KyriePakpahan/chipathon26-SAR_ADC/docs/images/adc_fft.png

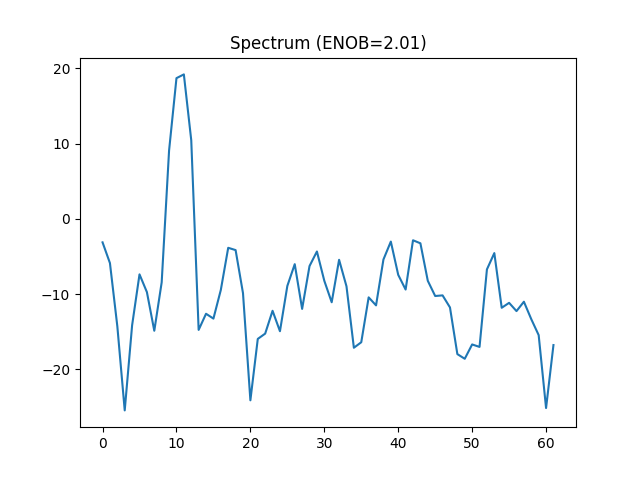
docs/images/adc_fft.png
