KyriePakpahan/chipathon26-SAR_ADC/docs/images/adc_output.png

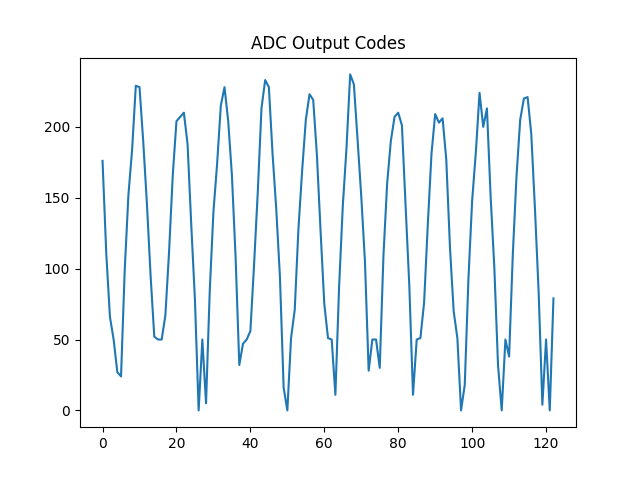
docs/images/adc_output.png
