KyriePakpahan/chipathon26-SAR_ADC/docs/images/async_sar_schematic.png

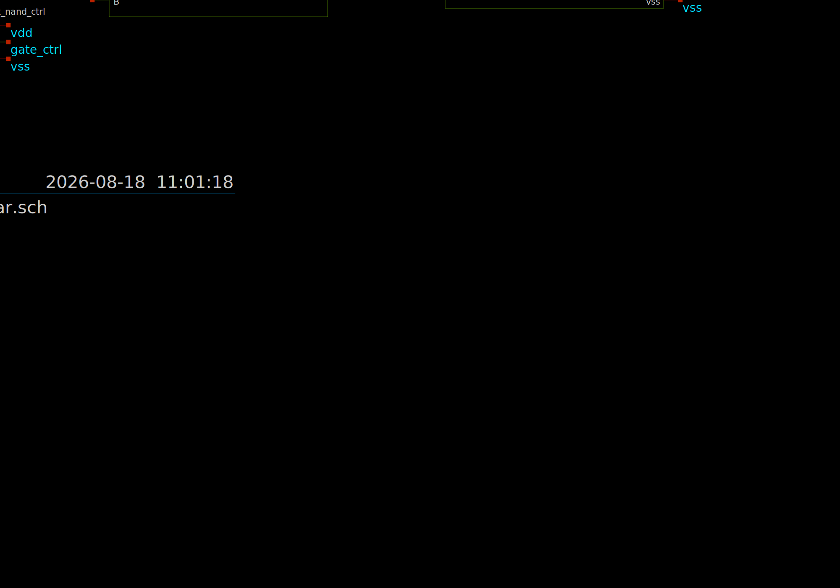
docs/images/async_sar_schematic.png
