KyriePakpahan/chipathon26-SAR_ADC/docs/images/code_vs_vin.png

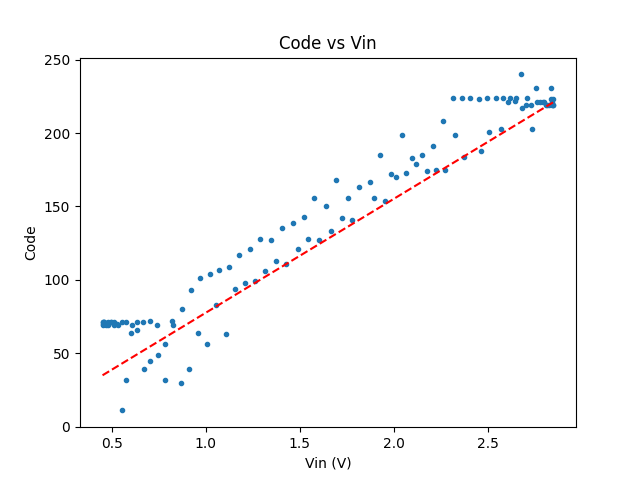
docs/images/code_vs_vin.png
