KyriePakpahan/chipathon26-SAR_ADC/docs/images/dynamic_fft_spectra_annotated.png

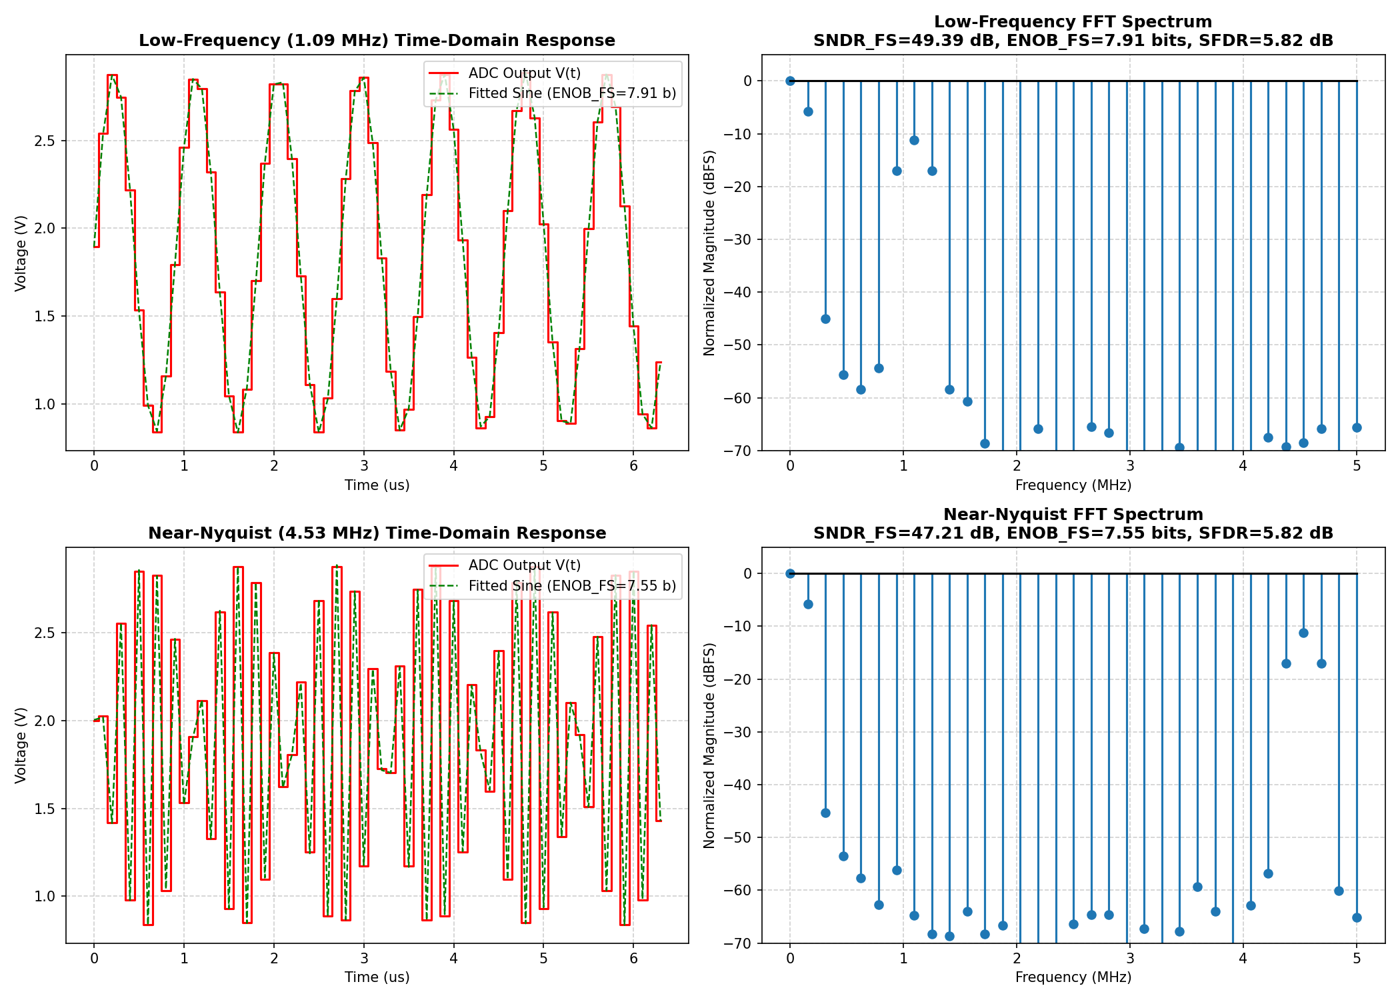
docs/images/dynamic_fft_spectra_annotated.png
