KyriePakpahan/chipathon26-SAR_ADC/docs/images/error_vs_time.png

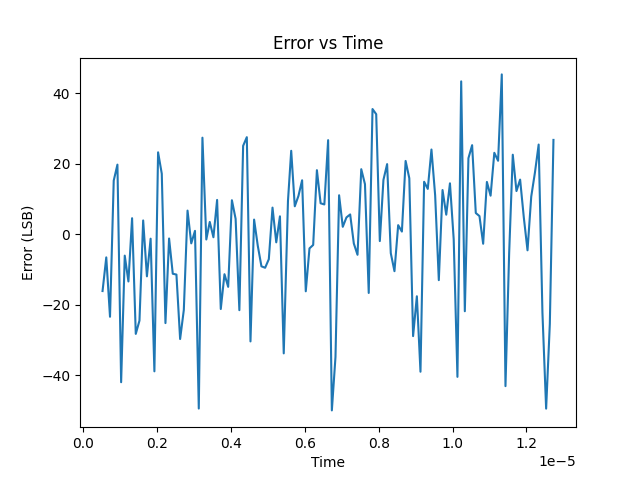
docs/images/error_vs_time.png
