KyriePakpahan/chipathon26-SAR_ADC/docs/images/error_vs_vin.png

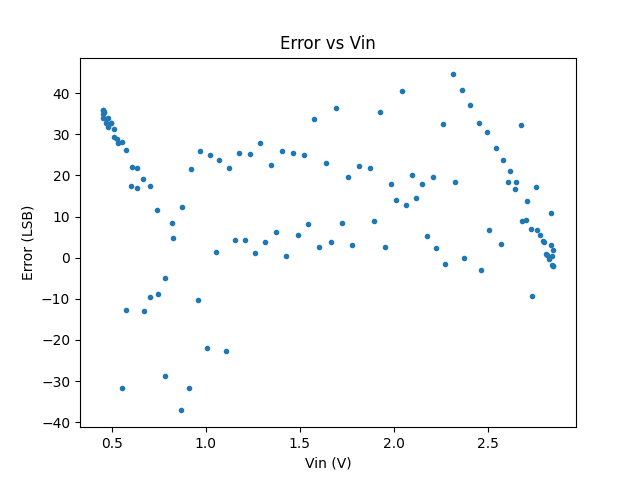
docs/images/error_vs_vin.png
