KyriePakpahan/chipathon26-SAR_ADC/docs/images/fft_out.png

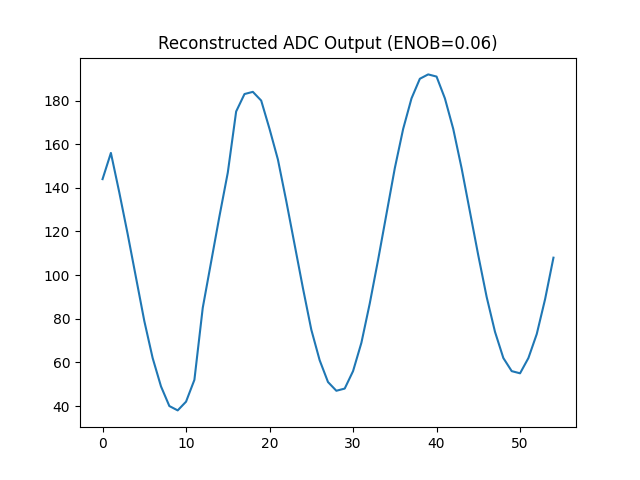
docs/images/fft_out.png
