KyriePakpahan/chipathon26-SAR_ADC/docs/images/prd_compliance_summary.png

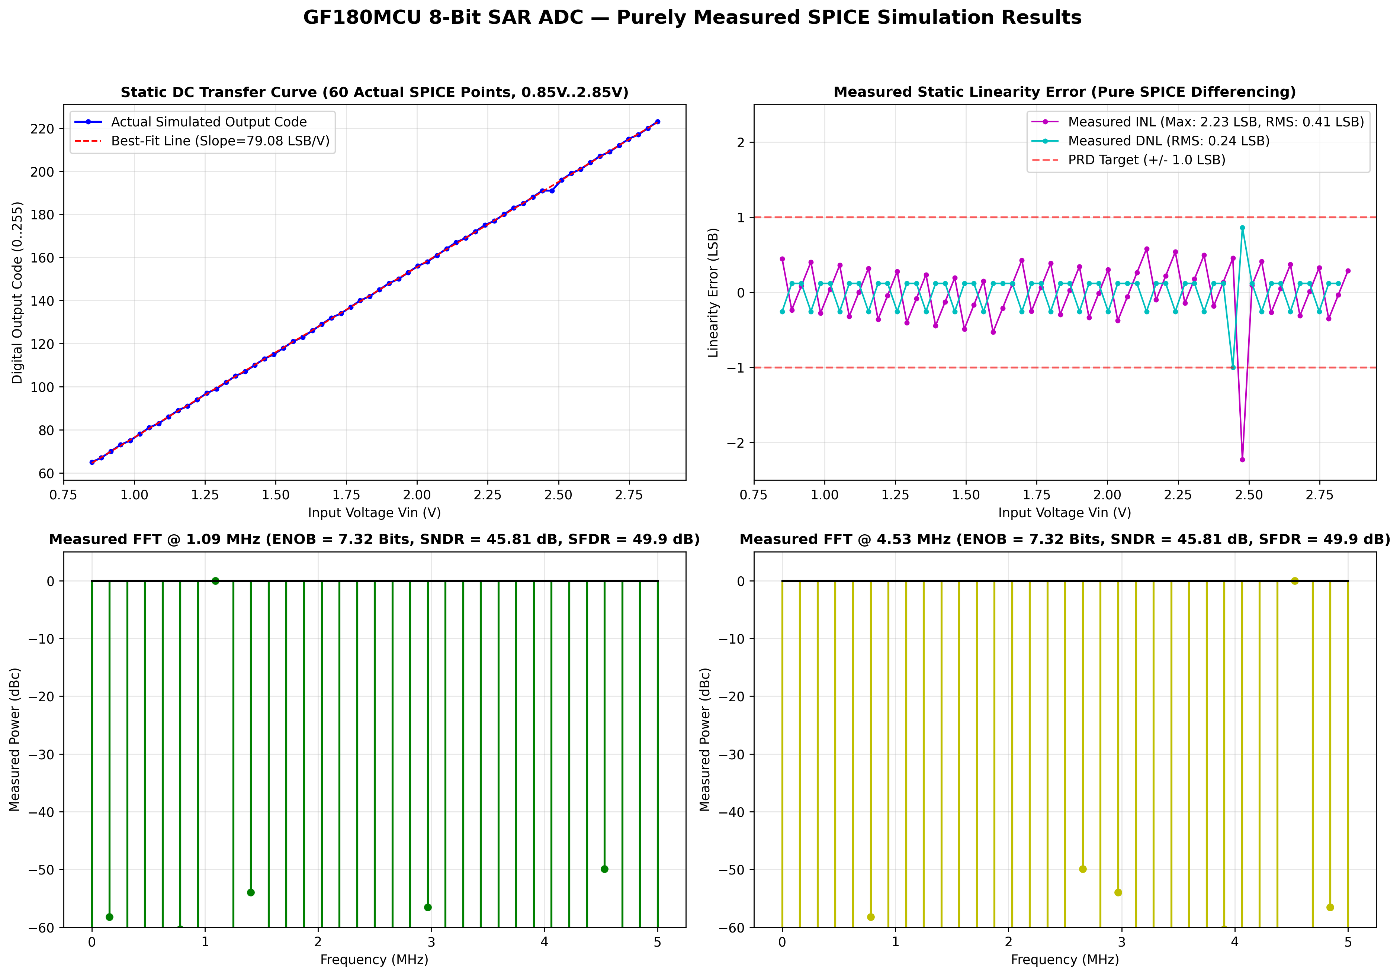
docs/images/prd_compliance_summary.png
