KyriePakpahan/chipathon26-SAR_ADC/docs/images/tb_sar_adc_top_waveform.png

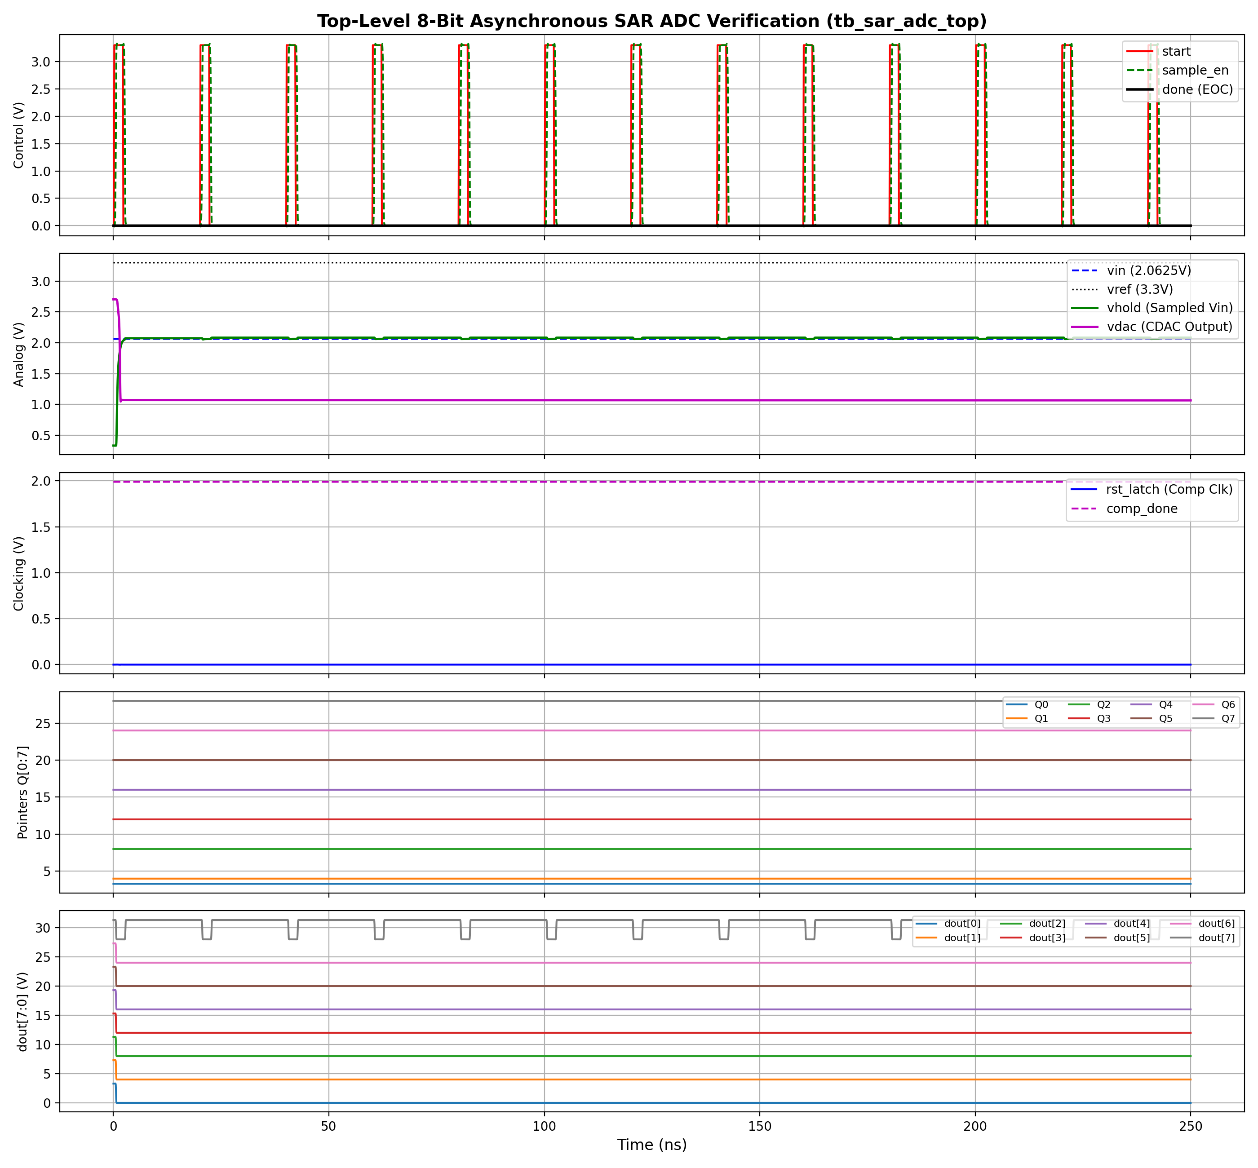
docs/images/tb_sar_adc_top_waveform.png
