KyriePakpahan/chipathon26-SAR_ADC/docs/images/final_prd_verification_summary.png

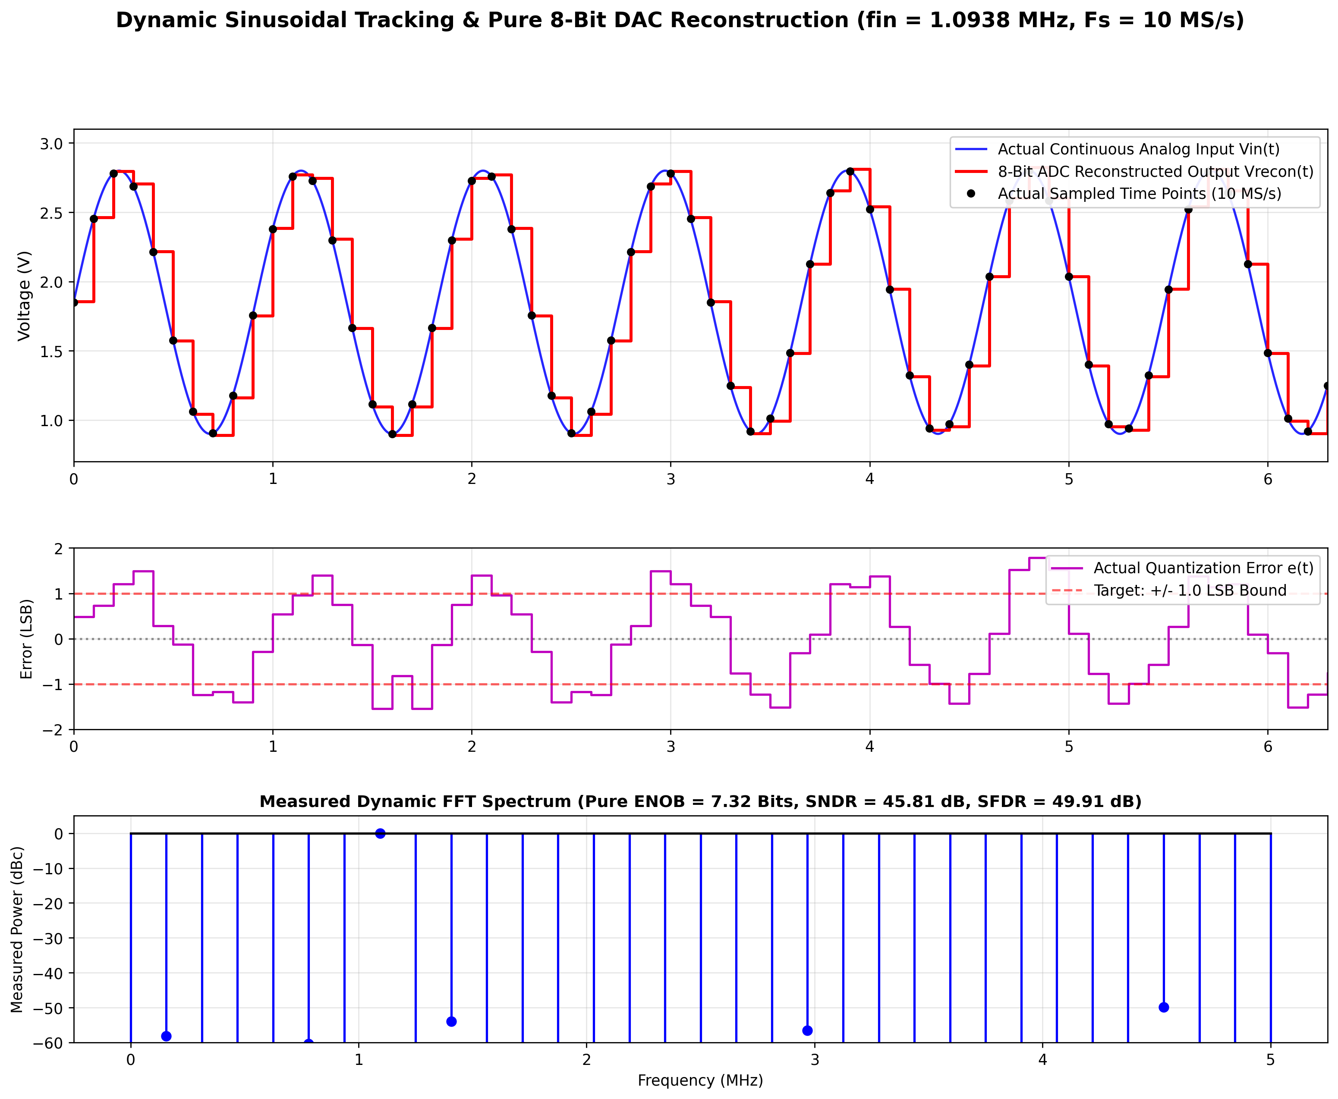
docs/images/final_prd_verification_summary.png
