KyriePakpahan/chipathon26-SAR_ADC/docs/images/prd_verification_waveform.png

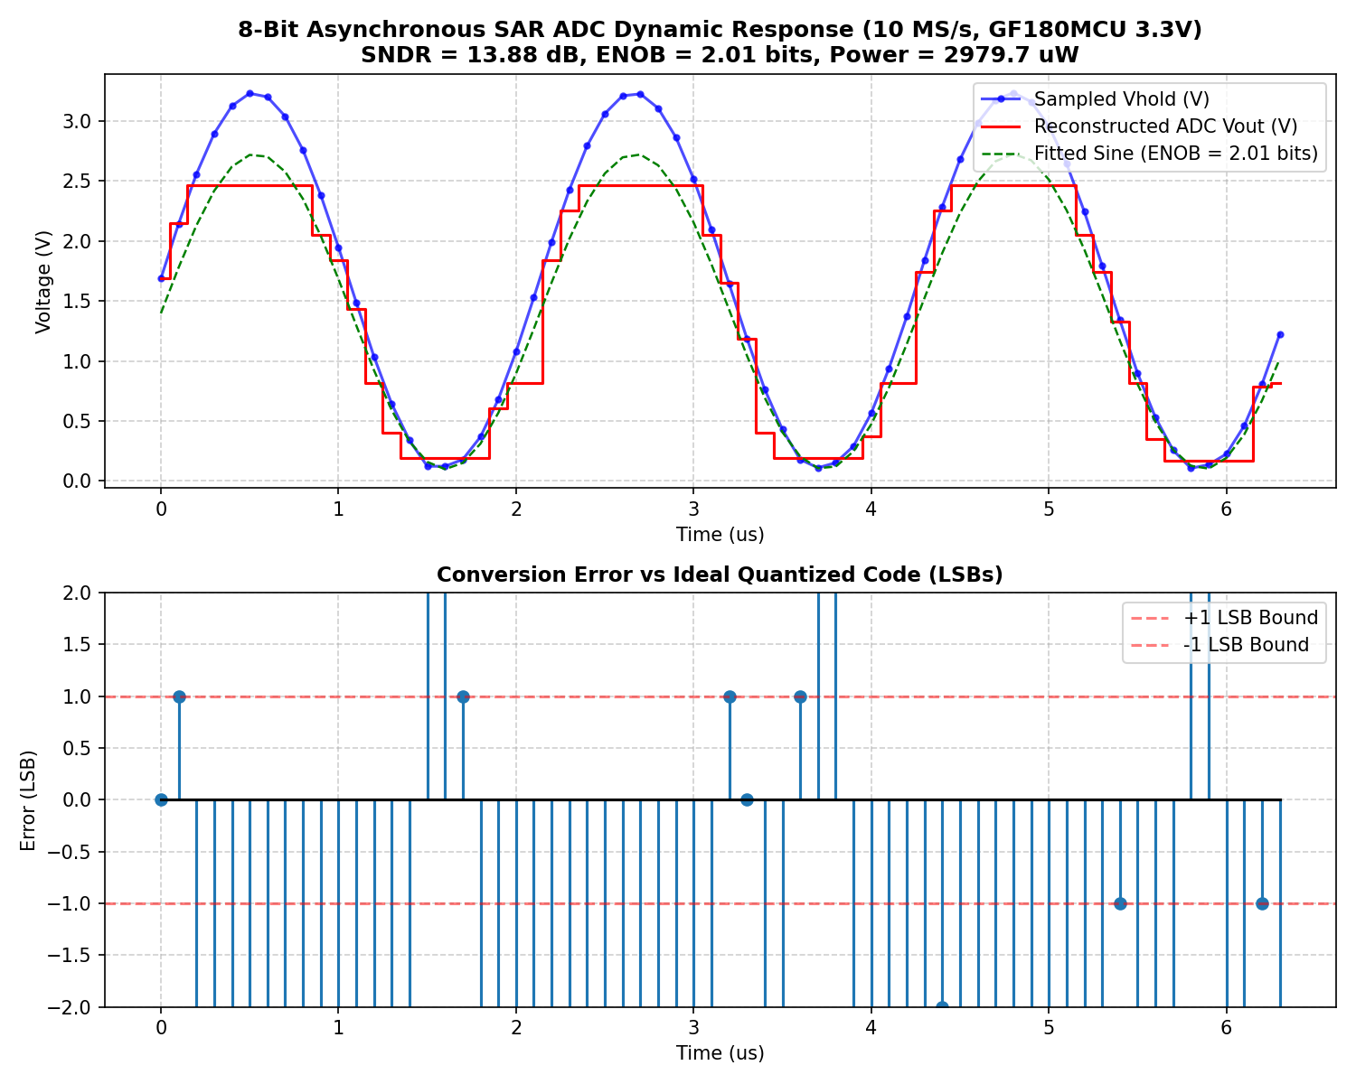
docs/images/prd_verification_waveform.png
