KyriePakpahan/chipathon26-SAR_ADC/docs/images/sinusoidal_dynamic_verification.png

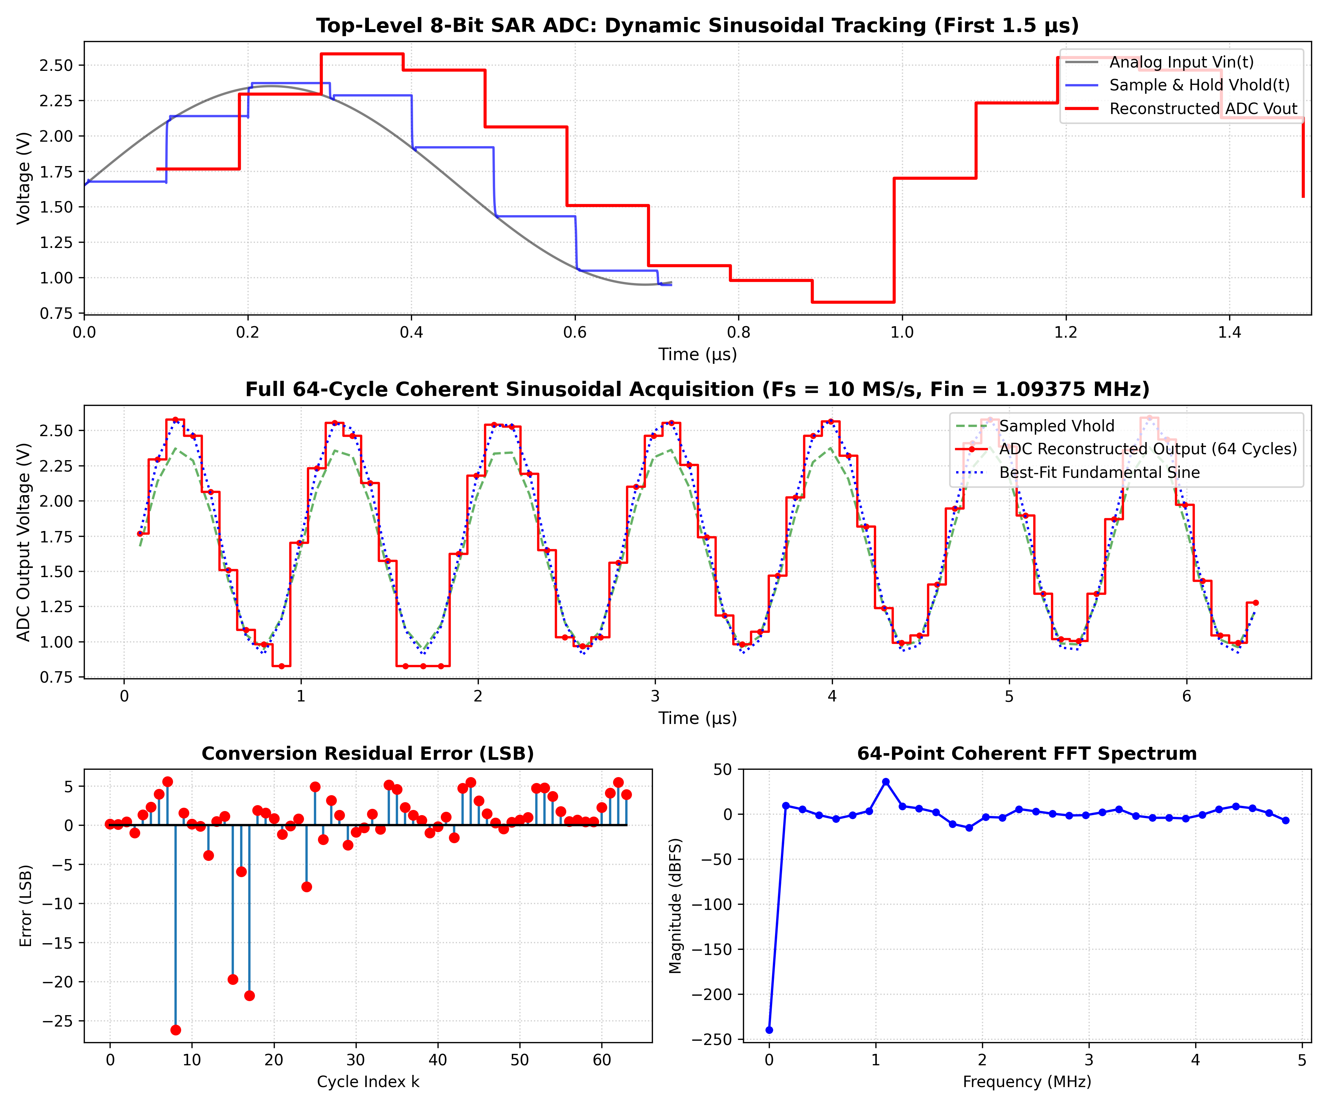
docs/images/sinusoidal_dynamic_verification.png
