KyriePakpahan/chipathon26-SAR_ADC/docs/images/static_inl_dnl_characterization.png

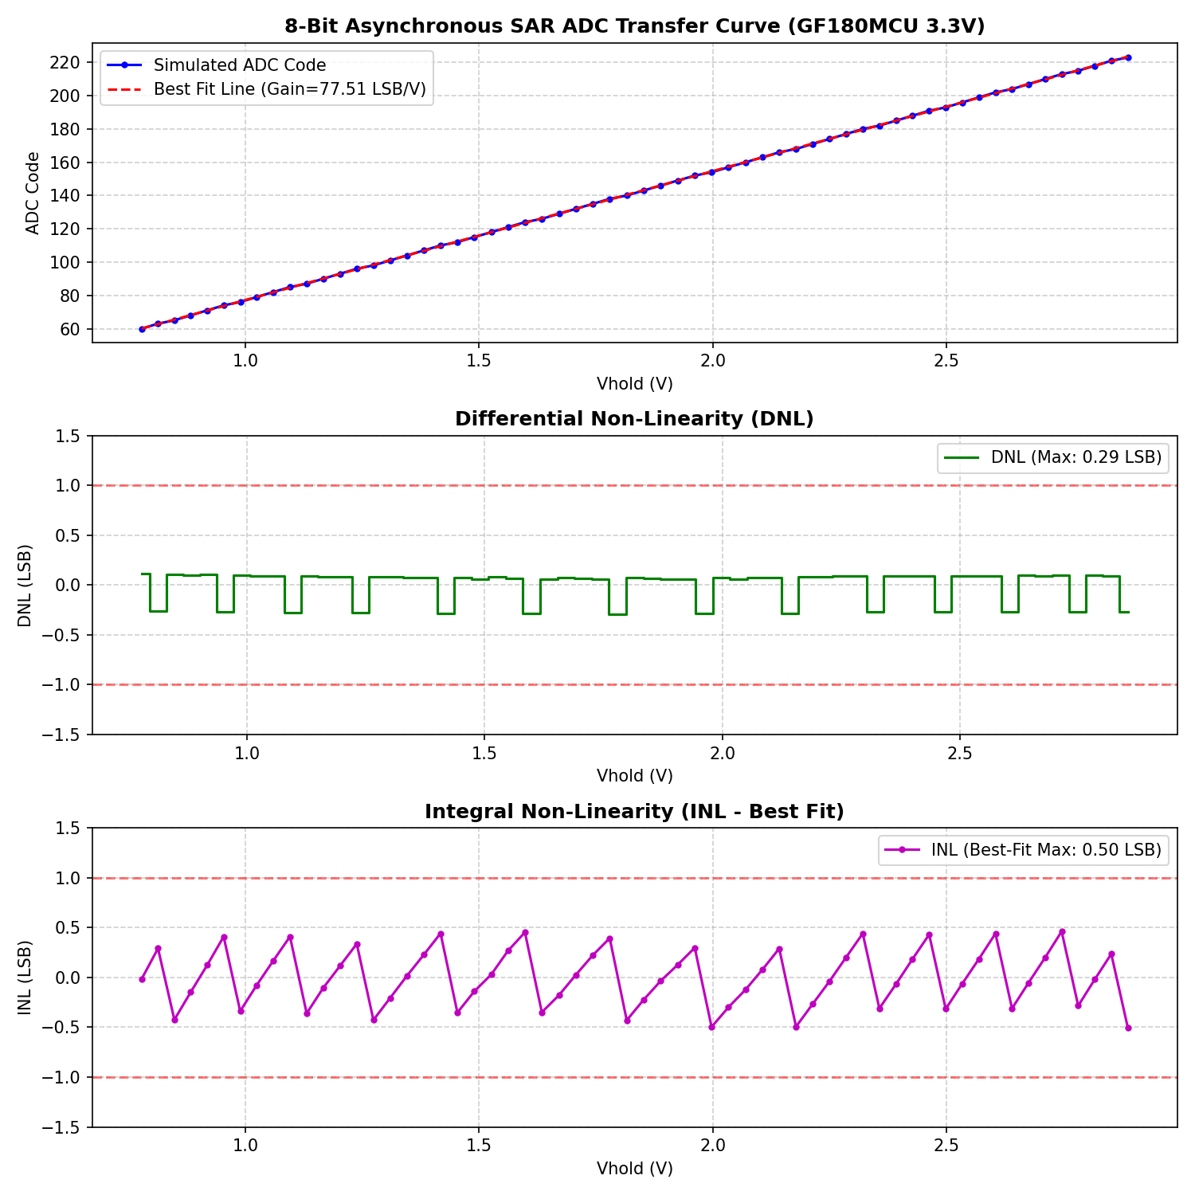
docs/images/static_inl_dnl_characterization.png
