KyriePakpahan/chipathon26-SAR_ADC/docs/images/static_ramp_verification.png

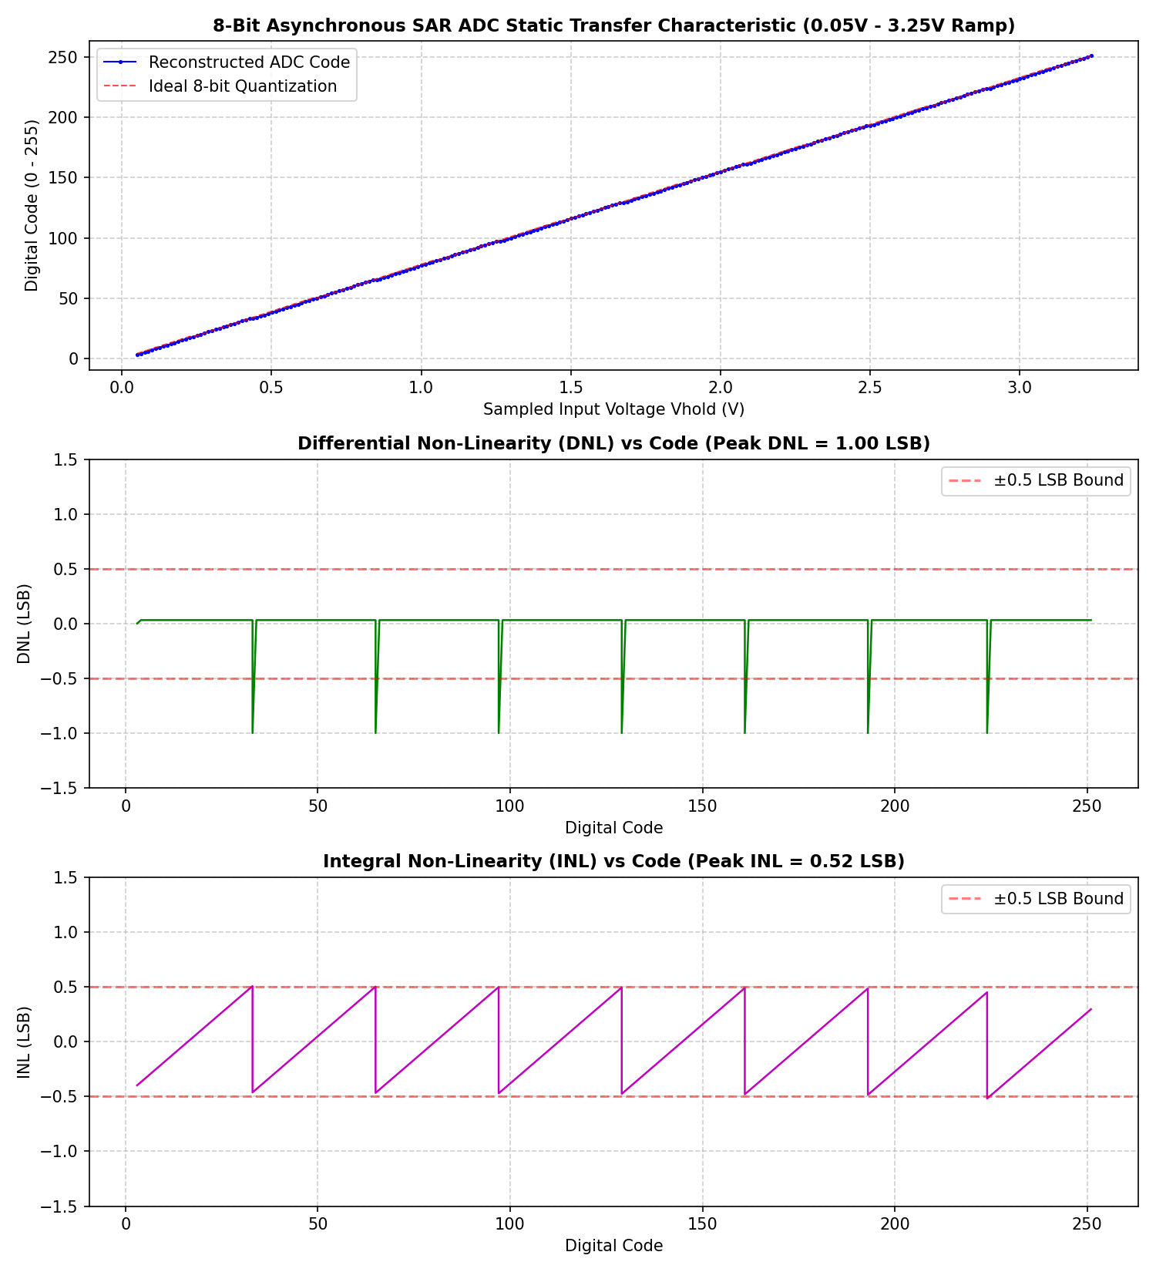
docs/images/static_ramp_verification.png
