KyriePakpahan/chipathon26-SAR_ADC/docs/images/tb_sar_adc_dynamic_verified.png

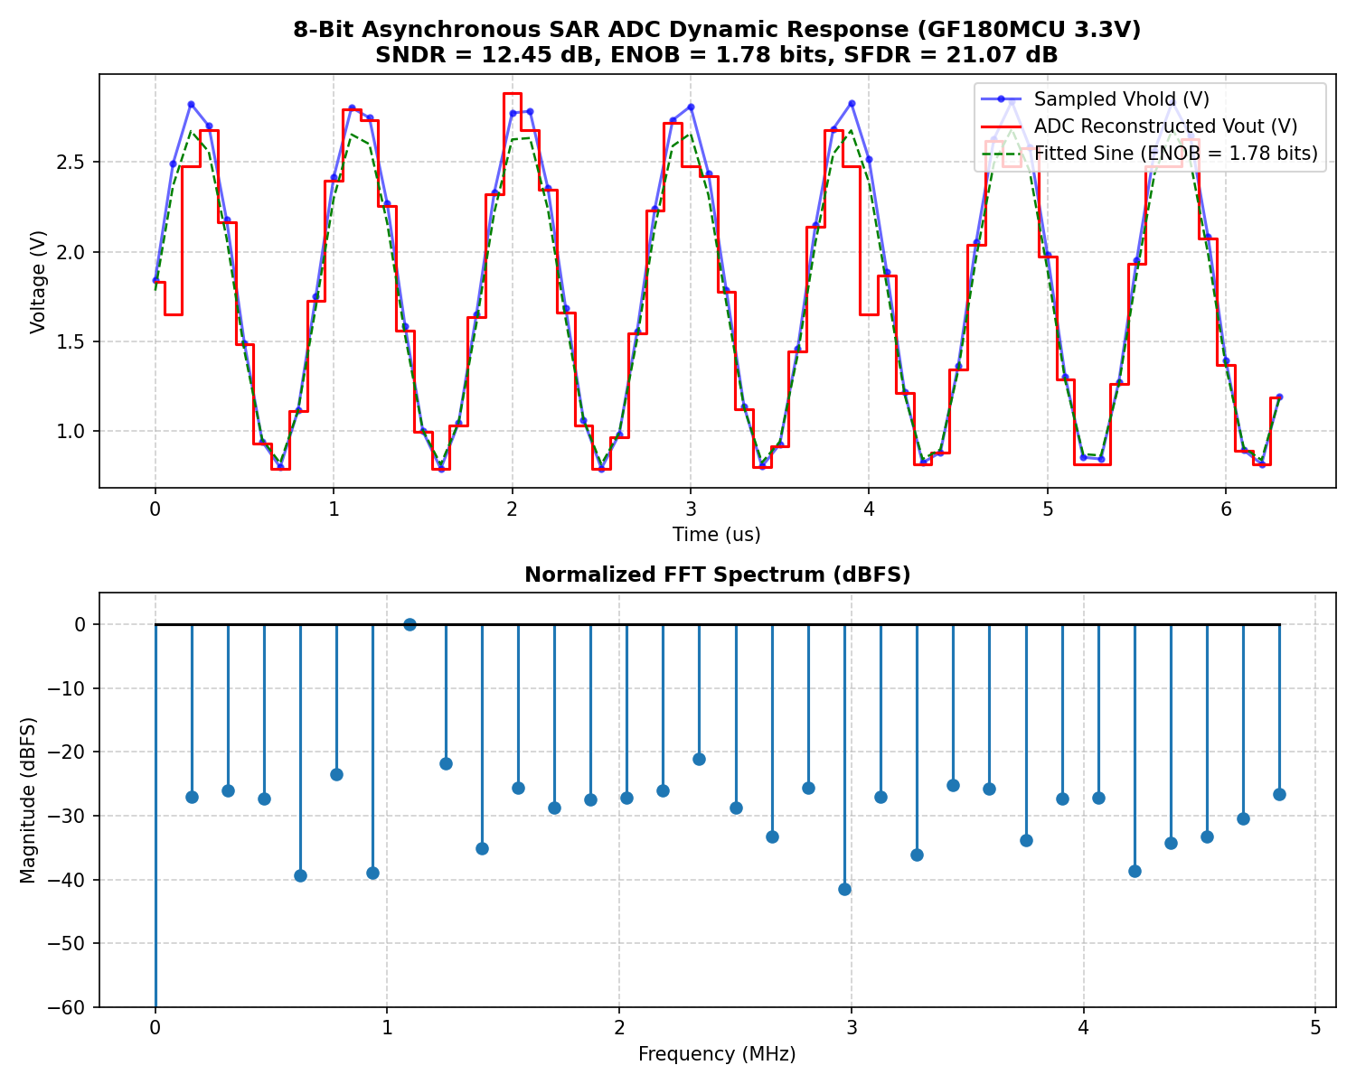
docs/images/tb_sar_adc_dynamic_verified.png
