KyriePakpahan/chipathon26-SAR_ADC/docs/images/tb_sar_adc_top_verified.png

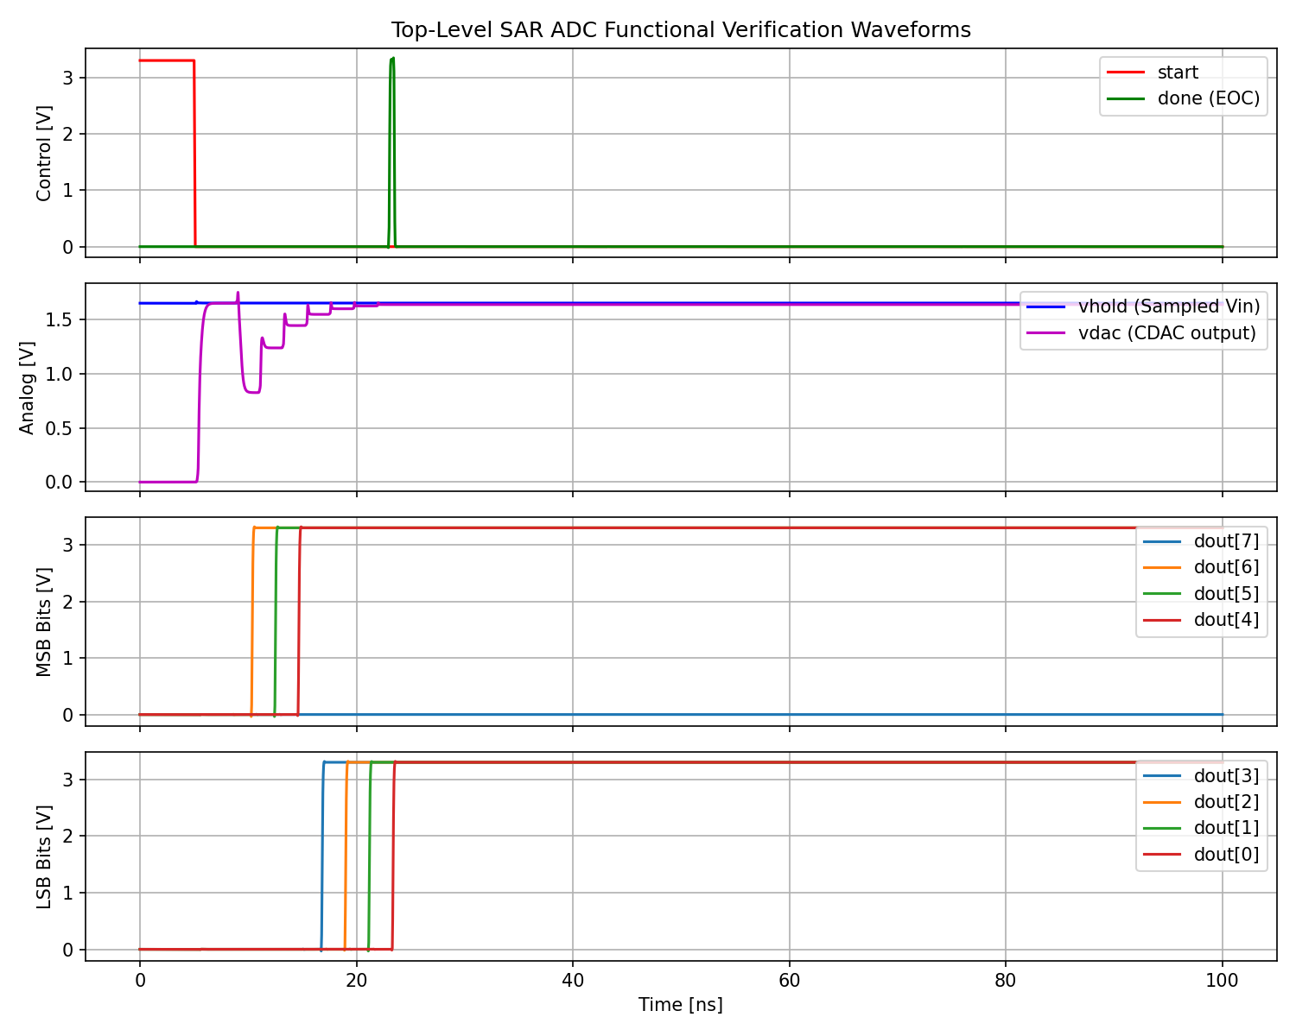
docs/images/tb_sar_adc_top_verified.png
