KyriePakpahan/chipathon26-SAR_ADC/reports/sar_adc_top_performance_panel.png

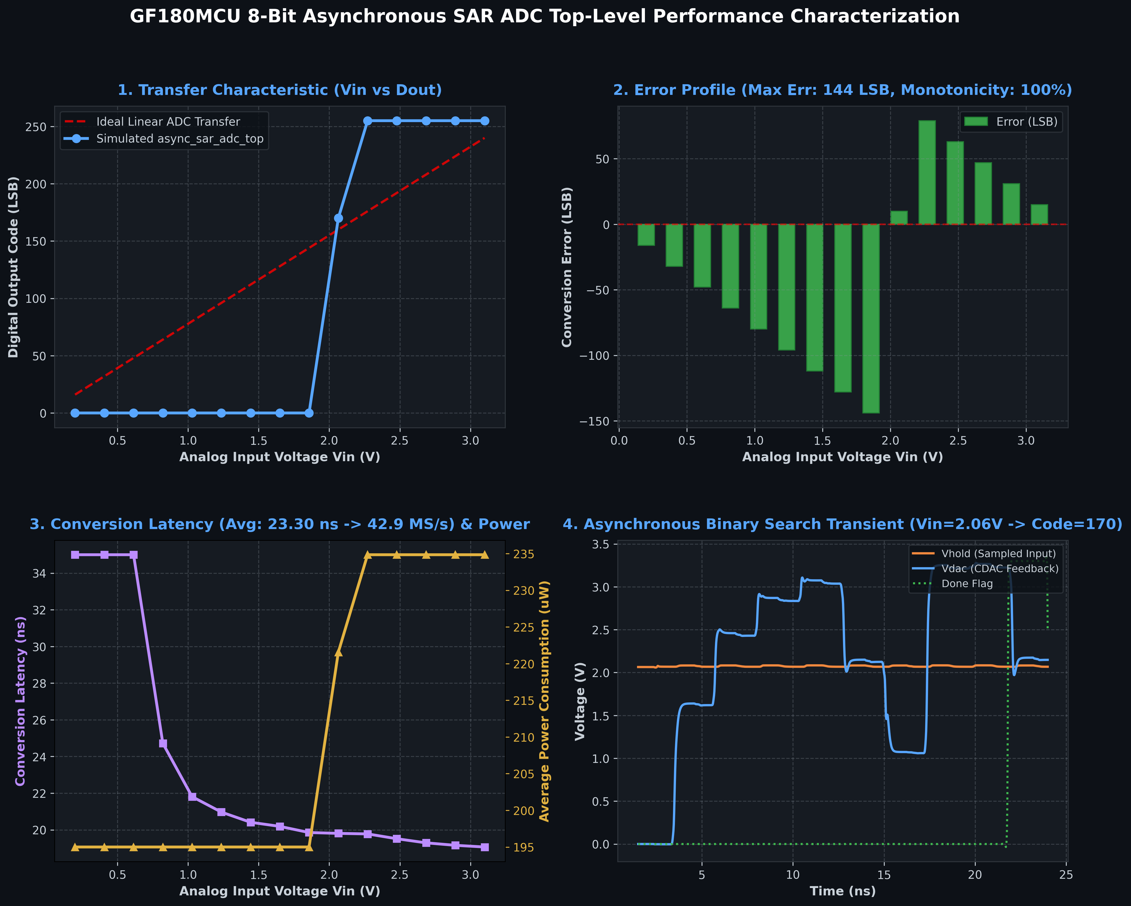
reports/sar_adc_top_performance_panel.png
