KyriePakpahan/chipathon26-SAR_ADC/xschem/sar_adc/blocks/sample_hold/testbench/tb_sample_hold.spice

** sch_path: /foss/designs/chipathon26-SAR_ADC/xschem/sar_adc/blocks/sample_hold/testbench/tb_sample_hold.sch
**.subckt tb_sample_hold
V_VDD vdd 0 3.3
V_VIN vin 0 SINE(1.65 1.5 1Meg)
V_SE sample_en 0 PULSE(0 3.3 0 1n 1n 50n 100n)
x1 vin sample_en vhold vdd 0 sample_hold
**** begin user architecture code


.param fnoicor=0
.param sw_stat_mismatch=0
.include /foss/pdks/gf180mcuD/libs.tech/ngspice/design.ngspice
.lib /foss/pdks/gf180mcuD/libs.tech/ngspice/sm141064.ngspice typical
.lib /foss/pdks/gf180mcuD/libs.tech/ngspice/sm141064.ngspice mimcap_typical
.lib /foss/pdks/gf180mcuD/libs.tech/ngspice/sm141064.ngspice cap_mim
.control
save v(vin) v(sample_en) v(vhold)
tran 0.1n 500n
set filetype=ascii
write tb_sample_hold.raw
quit
.endc

**** end user architecture code
**.ends

* expanding   symbol:  sar_adc/blocks/sample_hold/sample_hold.sym # of pins=5
** sym_path: /foss/designs/chipathon26-SAR_ADC/xschem/sar_adc/blocks/sample_hold/sample_hold.sym
** sch_path: /foss/designs/chipathon26-SAR_ADC/xschem/sar_adc/blocks/sample_hold/sample_hold.sch
.subckt sample_hold vin sample_en vhold vdd vss
*.ipin vin
*.ipin sample_en
*.opin vhold
*.iopin vdd
*.iopin vss
x_inv vdd clkb sample_en vss inv_sh
XC1 net1 vg cap_mim_2f0fF c_width=10e-6 c_length=25e-6
XM4 vin sample_en net1 vss nfet_03v3 L=0.28u W=2.00u nf=1 ad='int((nf+1)/2) * W/nf * 0.18u' as='int((nf+2)/2) * W/nf * 0.18u' pd='2*int((nf+1)/2) * (W/nf + 0.18u)'
+ ps='2*int((nf+2)/2) * (W/nf + 0.18u)' nrd='0.18u / W' nrs='0.18u / W' sa=0 sb=0 sd=0
XM3 vss clkb net1 vss nfet_03v3 L=0.28u W=2.00u nf=1 ad='int((nf+1)/2) * W/nf * 0.18u' as='int((nf+2)/2) * W/nf * 0.18u' pd='2*int((nf+1)/2) * (W/nf + 0.18u)'
+ ps='2*int((nf+2)/2) * (W/nf + 0.18u)' nrd='0.18u / W' nrs='0.18u / W' sa=0 sb=0 sd=0
XM5 vg vg vdd vdd pfet_03v3 L=0.28u W=2.00u nf=1 ad='int((nf+1)/2) * W/nf * 0.18u' as='int((nf+2)/2) * W/nf * 0.18u' pd='2*int((nf+1)/2) * (W/nf + 0.18u)'
+ ps='2*int((nf+2)/2) * (W/nf + 0.18u)' nrd='0.18u / W' nrs='0.18u / W' sa=0 sb=0 sd=0
XM6 vg clkb vg vdd pfet_03v3 L=0.28u W=2.00u nf=1 ad='int((nf+1)/2) * W/nf * 0.18u' as='int((nf+2)/2) * W/nf * 0.18u' pd='2*int((nf+1)/2) * (W/nf + 0.18u)'
+ ps='2*int((nf+2)/2) * (W/nf + 0.18u)' nrd='0.18u / W' nrs='0.18u / W' sa=0 sb=0 sd=0
XM7 net2 vdd vg vss nfet_03v3 L=0.28u W=2.00u nf=1 ad='int((nf+1)/2) * W/nf * 0.18u' as='int((nf+2)/2) * W/nf * 0.18u' pd='2*int((nf+1)/2) * (W/nf + 0.18u)'
+ ps='2*int((nf+2)/2) * (W/nf + 0.18u)' nrd='0.18u / W' nrs='0.18u / W' sa=0 sb=0 sd=0
XM8 vss clkb net2 vss nfet_03v3 L=0.28u W=2.00u nf=1 ad='int((nf+1)/2) * W/nf * 0.18u' as='int((nf+2)/2) * W/nf * 0.18u' pd='2*int((nf+1)/2) * (W/nf + 0.18u)'
+ ps='2*int((nf+2)/2) * (W/nf + 0.18u)' nrd='0.18u / W' nrs='0.18u / W' sa=0 sb=0 sd=0
XM1 vhold vg vin vss nfet_03v3 L=0.28u W=5.00u nf=1 ad='int((nf+1)/2) * W/nf * 0.18u' as='int((nf+2)/2) * W/nf * 0.18u' pd='2*int((nf+1)/2) * (W/nf + 0.18u)'
+ ps='2*int((nf+2)/2) * (W/nf + 0.18u)' nrd='0.18u / W' nrs='0.18u / W' sa=0 sb=0 sd=0
XM2 vin clkb vhold vdd pfet_03v3 L=0.28u W=5.00u nf=1 ad='int((nf+1)/2) * W/nf * 0.18u' as='int((nf+2)/2) * W/nf * 0.18u' pd='2*int((nf+1)/2) * (W/nf + 0.18u)'
+ ps='2*int((nf+2)/2) * (W/nf + 0.18u)' nrd='0.18u / W' nrs='0.18u / W' sa=0 sb=0 sd=0
XC2 vhold vss cap_mim_2f0fF c_width=20e-6 c_length=10e-6
.ends


* expanding   symbol:  sar_adc/blocks/sample_hold/inv_sh.sym # of pins=4
** sym_path: /foss/designs/chipathon26-SAR_ADC/xschem/sar_adc/blocks/sample_hold/inv_sh.sym
** sch_path: /foss/designs/chipathon26-SAR_ADC/xschem/sar_adc/blocks/sample_hold/inv_sh.sch
.subckt inv_sh vdd vo vi vss
*.iopin vdd
*.ipin vi
*.opin vo
*.iopin vss
XM1 vo vi vss vss nfet_03v3 L=0.28u W=1u nf=1 ad='int((nf+1)/2) * W/nf * 0.18u' as='int((nf+2)/2) * W/nf * 0.18u' pd='2*int((nf+1)/2) * (W/nf + 0.18u)'
+ ps='2*int((nf+2)/2) * (W/nf + 0.18u)' nrd='0.18u / W' nrs='0.18u / W' sa=0 sb=0 sd=0
XM2 vo vi vdd vdd pfet_03v3 L=0.28u W=2u nf=1 ad='int((nf+1)/2) * W/nf * 0.18u' as='int((nf+2)/2) * W/nf * 0.18u' pd='2*int((nf+1)/2) * (W/nf + 0.18u)'
+ ps='2*int((nf+2)/2) * (W/nf + 0.18u)' nrd='0.18u / W' nrs='0.18u / W' sa=0 sb=0 sd=0
.ends

.end
