KyriePakpahan/chipathon26-SAR_ADC/netlist/sar_adc_top.spice

** sch_path: /foss/designs/chipathon26-SAR_ADC/xschem/sar_adc/sar_adc_top.sch
.subckt sar_adc_top vin vref start vdd vss done dout[7] dout[6] dout[5] dout[4] dout[3] dout[2] dout[1] dout[0]
*.ipin vin
*.ipin vref
*.ipin start
*.iopin vdd
*.iopin vss
*.opin done
*.opin dout[7]
*.opin dout[6]
*.opin dout[5]
*.opin dout[4]
*.opin dout[3]
*.opin dout[2]
*.opin dout[1]
*.opin dout[0]
x_sh vin sample_en vhold vdd vss sample_hold
x_cdac vref dac_in[7] dac_in[6] dac_in[5] dac_in[4] dac_in[3] dac_in[2] dac_in[1] dac_in[0] vdac vdd vss cdac_8bit
x_comp vhold vdac rst_latch vdd vss comp_out_p comp_out_n comp_done strongarm_comp
x_sar start comp_out_p comp_done vdd vss sample_en rst_latch done dout[7] dout[6] dout[5] dout[4] dout[3] dout[2] dout[1] dout[0]
+ dac_in[7] dac_in[6] dac_in[5] dac_in[4] dac_in[3] dac_in[2] dac_in[1] dac_in[0] async_sar
x_dac_rst vdac sample_en vss dac_rst
x_dec_vref vref vss dec_vref
.ends

* expanding   symbol:  sar_adc/blocks/sample_hold/sample_hold.sym # of pins=5
** sym_path: /foss/designs/chipathon26-SAR_ADC/xschem/sar_adc/blocks/sample_hold/sample_hold.sym
** sch_path: /foss/designs/chipathon26-SAR_ADC/xschem/sar_adc/blocks/sample_hold/sample_hold.sch
.subckt sample_hold vin sample_en vhold vdd vss
*.ipin vin
*.ipin sample_en
*.opin vhold
*.iopin vdd
*.iopin vss
XM1 vhold sample_en vin vss nfet_03v3 L=0.28u W=8.00u nf=4 ad='int((nf+1)/2) * W/nf * 0.18u' as='int((nf+2)/2) * W/nf * 0.18u' pd='2*int((nf+1)/2) * (W/nf + 0.18u)'
+ ps='2*int((nf+2)/2) * (W/nf + 0.18u)' nrd='0.18u / W' nrs='0.18u / W' sa=0 sb=0 sd=0
XM2 vin clkb vhold vdd pfet_03v3 L=0.28u W=16.00u nf=4 ad='int((nf+1)/2) * W/nf * 0.18u' as='int((nf+2)/2) * W/nf * 0.18u' pd='2*int((nf+1)/2) * (W/nf + 0.18u)'
+ ps='2*int((nf+2)/2) * (W/nf + 0.18u)' nrd='0.18u / W' nrs='0.18u / W' sa=0 sb=0 sd=0
XC2 vhold vss cap_mim_2f0fF c_width=15e-6 c_length=10e-6
XM3 clkb sample_en vdd vdd pfet_03v3 L=0.28u W=4.00u nf=2 ad='int((nf+1)/2) * W/nf * 0.18u' as='int((nf+2)/2) * W/nf * 0.18u' pd='2*int((nf+1)/2) * (W/nf + 0.18u)'
+ ps='2*int((nf+2)/2) * (W/nf + 0.18u)' nrd='0.18u / W' nrs='0.18u / W' sa=0 sb=0 sd=0
XM4 clkb sample_en vss vss nfet_03v3 L=0.28u W=2.00u nf=1 ad='int((nf+1)/2) * W/nf * 0.18u' as='int((nf+2)/2) * W/nf * 0.18u' pd='2*int((nf+1)/2) * (W/nf + 0.18u)'
+ ps='2*int((nf+2)/2) * (W/nf + 0.18u)' nrd='0.18u / W' nrs='0.18u / W' sa=0 sb=0 sd=0
.ends


* expanding   symbol:  sar_adc/blocks/cdac/cdac_8bit.sym # of pins=12
** sym_path: /foss/designs/chipathon26-SAR_ADC/xschem/sar_adc/blocks/cdac/cdac_8bit.sym
** sch_path: /foss/designs/chipathon26-SAR_ADC/xschem/sar_adc/blocks/cdac/cdac_8bit.sch
.subckt cdac_8bit vref dac_in[7] dac_in[6] dac_in[5] dac_in[4] dac_in[3] dac_in[2] dac_in[1] dac_in[0] vdac vdd vss
*.ipin vref
*.ipin dac_in[7]
*.ipin dac_in[6]
*.ipin dac_in[5]
*.ipin dac_in[4]
*.ipin dac_in[3]
*.ipin dac_in[2]
*.ipin dac_in[1]
*.ipin dac_in[0]
*.opin vdac
*.iopin vdd
*.iopin vss
X0 dac_in[0] vref vdd vss bot0 cdac_switch_1b
XC0 vdac bot0 cap_mim_2f0fF c_width=5e-6 c_length=5e-6
X1 dac_in[1] vref vdd vss bot1 cdac_switch_1b
XC1 vdac bot1 cap_mim_2f0fF c_width=5e-6 c_length=5e-6 m=2
X2 dac_in[2] vref vdd vss bot2 cdac_switch_1b
XC2 vdac bot2 cap_mim_2f0fF c_width=5e-6 c_length=5e-6 m=4
X3 dac_in[3] vref vdd vss bot3 cdac_switch_1b
XC3 vdac bot3 cap_mim_2f0fF c_width=5e-6 c_length=5e-6 m=8
X4 dac_in[4] vref vdd vss bot4 cdac_switch_1b
XC4 vdac bot4 cap_mim_2f0fF c_width=5e-6 c_length=5e-6 m=16
X5 dac_in[5] vref vdd vss bot5 cdac_switch_1b
XC5 vdac bot5 cap_mim_2f0fF c_width=5e-6 c_length=5e-6 m=32
X6 dac_in[6] vref vdd vss bot6 cdac_switch_1b
XC6 vdac bot6 cap_mim_2f0fF c_width=5e-6 c_length=5e-6 m=64
X7 dac_in[7] vref vdd vss bot7 cdac_switch_1b
XC7 vdac bot7 cap_mim_2f0fF c_width=5e-6 c_length=5e-6 m=128
XC8 vdac vss cap_mim_2f0fF c_width=5e-6 c_length=5e-6
.ends


* expanding   symbol:  sar_adc/blocks/comparator/strongarm_comp.sym # of pins=8
** sym_path: /foss/designs/chipathon26-SAR_ADC/xschem/sar_adc/blocks/comparator/strongarm_comp.sym
** sch_path: /foss/designs/chipathon26-SAR_ADC/xschem/sar_adc/blocks/comparator/strongarm_comp.sch
.subckt strongarm_comp vin_p vin_n rst_latch vdd vss out_p out_n comp_done
*.ipin vin_p
*.ipin vin_n
*.ipin rst_latch
*.iopin vdd
*.iopin vss
*.opin out_p
*.opin out_n
*.opin comp_done
x_core vin_p vin_n rst_latch vdd vss raw_p raw_n strongarm_comp_core
x_inv_p raw_p out_p vdd vss comp_inv_3v3
x_inv_n raw_n out_n vdd vss comp_inv_3v3
x_done_xor out_p out_n comp_done vdd vss comp_xor_fast
.ends


* expanding   symbol:  sar_adc/blocks/async_sar/async_sar.sym # of pins=24
** sym_path: /foss/designs/chipathon26-SAR_ADC/xschem/sar_adc/blocks/async_sar/async_sar.sym
** sch_path: /foss/designs/chipathon26-SAR_ADC/xschem/sar_adc/blocks/async_sar/async_sar.sch
.subckt async_sar start comp_out_p comp_done vdd vss sample_en rst_latch done dout[7] dout[6] dout[5] dout[4] dout[3] dout[2]
+ dout[1] dout[0] dac_in[7] dac_in[6] dac_in[5] dac_in[4] dac_in[3] dac_in[2] dac_in[1] dac_in[0]
*.ipin start
*.ipin comp_out_p
*.ipin comp_done
*.iopin vdd
*.iopin vss
*.opin sample_en
*.opin rst_latch
*.opin done
*.opin dout[7]
*.opin dout[6]
*.opin dout[5]
*.opin dout[4]
*.opin dout[3]
*.opin dout[2]
*.opin dout[1]
*.opin dout[0]
*.opin dac_in[7]
*.opin dac_in[6]
*.opin dac_in[5]
*.opin dac_in[4]
*.opin dac_in[3]
*.opin dac_in[2]
*.opin dac_in[1]
*.opin dac_in[0]
x_inv_srclk vdd comp_done comp_done_b vss async_inverter
x_sr8 vdd vss Q0 Q1 Q2 Q3 Q4 Q5 Q6 Q7 sr_done vss comp_done_b rst_n_int shift_reg_8bit
x_inv_se1 vdd start start_inv vss async_inverter
x_inv_se2 vdd start_inv sample_en vss async_inverter
x_inv_rst_n_int vdd start rst_n_int vss async_inverter
x_bit0 vdd vss dout[0] comp_out_p Q7 rst_n_int bit_reg
x_nor_dq0 dout[0] Q7 dac_n0 vdd vss async_nor2
x_nor_st0 dac_n0 start dac_in[0] vdd vss async_nor2
x_bit1 vdd vss dout[1] comp_out_p Q6 rst_n_int bit_reg
x_nor_dq1 dout[1] Q6 dac_n1 vdd vss async_nor2
x_nor_st1 dac_n1 start dac_in[1] vdd vss async_nor2
x_bit2 vdd vss dout[2] comp_out_p Q5 rst_n_int bit_reg
x_nor_dq2 dout[2] Q5 dac_n2 vdd vss async_nor2
x_nor_st2 dac_n2 start dac_in[2] vdd vss async_nor2
x_bit3 vdd vss dout[3] comp_out_p Q4 rst_n_int bit_reg
x_nor_dq3 dout[3] Q4 dac_n3 vdd vss async_nor2
x_nor_st3 dac_n3 start dac_in[3] vdd vss async_nor2
x_bit4 vdd vss dout[4] comp_out_p Q3 rst_n_int bit_reg
x_nor_dq4 dout[4] Q3 dac_n4 vdd vss async_nor2
x_nor_st4 dac_n4 start dac_in[4] vdd vss async_nor2
x_bit5 vdd vss dout[5] comp_out_p Q2 rst_n_int bit_reg
x_nor_dq5 dout[5] Q2 dac_n5 vdd vss async_nor2
x_nor_st5 dac_n5 start dac_in[5] vdd vss async_nor2
x_bit6 vdd vss dout[6] comp_out_p Q1 rst_n_int bit_reg
x_nor_dq6 dout[6] Q1 dac_n6 vdd vss async_nor2
x_nor_st6 dac_n6 start dac_in[6] vdd vss async_nor2
x_bit7 vdd vss dout[7] comp_out_p Q0 rst_n_int bit_reg
x_nor_dq7 dout[7] Q0 dac_n7 vdd vss async_nor2
x_nor_st7 dac_n7 start dac_in[7] vdd vss async_nor2
x_psettle vdd vss comp_done gate_settle async_pulse_settle
x_start_del vdd vss start start_n async_start_delay
x_inv_dn vdd done done_n vss async_inverter
x_nand_ctrl vdd vss start_n gate_ctrl done_n async_nand2
x_nor_rstl gate_settle gate_ctrl rst_latch vdd vss async_nor2
x_nand_done vdd vss Q7 done_nand comp_done async_nand2
x_inv_done vdd done_nand done vss async_inverter
.ends


* expanding   symbol:  sar_adc/blocks/dac_rst/dac_rst.sym # of pins=3
** sym_path: /foss/designs/chipathon26-SAR_ADC/xschem/sar_adc/blocks/dac_rst/dac_rst.sym
** sch_path: /foss/designs/chipathon26-SAR_ADC/xschem/sar_adc/blocks/dac_rst/dac_rst.sch
.subckt dac_rst vdac sample_en vss
*.iopin vdac
*.ipin sample_en
*.iopin vss
XM1 vdac sample_en vss vss nfet_03v3 L=0.28u W=24.00u nf=6 ad='int((nf+1)/2) * W/nf * 0.18u' as='int((nf+2)/2) * W/nf * 0.18u' pd='2*int((nf+1)/2) * (W/nf + 0.18u)'
+ ps='2*int((nf+2)/2) * (W/nf + 0.18u)' nrd='0.18u / W' nrs='0.18u / W' sa=0 sb=0 sd=0
.ends


* expanding   symbol:  sar_adc/blocks/dec_vref/dec_vref.sym # of pins=2
** sym_path: /foss/designs/chipathon26-SAR_ADC/xschem/sar_adc/blocks/dec_vref/dec_vref.sym
** sch_path: /foss/designs/chipathon26-SAR_ADC/xschem/sar_adc/blocks/dec_vref/dec_vref.sch
.subckt dec_vref vref vss
*.iopin vref
*.iopin vss
XC1 vref vss cap_mim_2f0fF c_width=10e-6 c_length=10e-6 m=20
.ends


* expanding   symbol:  sar_adc/blocks/cdac/cdac_switch_1b.sym # of pins=5
** sym_path: /foss/designs/chipathon26-SAR_ADC/xschem/sar_adc/blocks/cdac/cdac_switch_1b.sym
** sch_path: /foss/designs/chipathon26-SAR_ADC/xschem/sar_adc/blocks/cdac/cdac_switch_1b.sch
.subckt cdac_switch_1b bit vref vdd vss bot
*.ipin bit
*.iopin vref
*.iopin vdd
*.iopin vss
*.iopin bot
XM1 bit_b bit vdd vdd pfet_03v3 L=0.28u W=16.0u nf=4 ad='int((nf+1)/2) * W/nf * 0.18u' as='int((nf+2)/2) * W/nf * 0.18u' pd='2*int((nf+1)/2) * (W/nf + 0.18u)'
+ ps='2*int((nf+2)/2) * (W/nf + 0.18u)' nrd='0.18u / W' nrs='0.18u / W' sa=0 sb=0 sd=0
XM2 bit_b bit vss vss nfet_03v3 L=0.28u W=8.0u nf=2 ad='int((nf+1)/2) * W/nf * 0.18u' as='int((nf+2)/2) * W/nf * 0.18u' pd='2*int((nf+1)/2) * (W/nf + 0.18u)'
+ ps='2*int((nf+2)/2) * (W/nf + 0.18u)' nrd='0.18u / W' nrs='0.18u / W' sa=0 sb=0 sd=0
XM3 bot bit_b vref vdd pfet_03v3 L=0.28u W=32.0u nf=8 ad='int((nf+1)/2) * W/nf * 0.18u' as='int((nf+2)/2) * W/nf * 0.18u' pd='2*int((nf+1)/2) * (W/nf + 0.18u)'
+ ps='2*int((nf+2)/2) * (W/nf + 0.18u)' nrd='0.18u / W' nrs='0.18u / W' sa=0 sb=0 sd=0
XM6 bot bit_b vss vss nfet_03v3 L=0.28u W=24.0u nf=6 ad='int((nf+1)/2) * W/nf * 0.18u' as='int((nf+2)/2) * W/nf * 0.18u' pd='2*int((nf+1)/2) * (W/nf + 0.18u)'
+ ps='2*int((nf+2)/2) * (W/nf + 0.18u)' nrd='0.18u / W' nrs='0.18u / W' sa=0 sb=0 sd=0
.ends


* expanding   symbol:  sar_adc/blocks/comparator/strongarm_comp_core.sym # of pins=7
** sym_path: /foss/designs/chipathon26-SAR_ADC/xschem/sar_adc/blocks/comparator/strongarm_comp_core.sym
** sch_path: /foss/designs/chipathon26-SAR_ADC/xschem/sar_adc/blocks/comparator/strongarm_comp_core.sch
.subckt strongarm_comp_core vin_p vin_n rst_latch vdd vss out_p out_n
*.ipin vin_p
*.ipin vin_n
*.ipin rst_latch
*.iopin vdd
*.iopin vss
*.opin out_p
*.opin out_n
XMtail net_tail rst_latch vss vss nfet_03v3 L=0.28u W=8.00u nf=2 ad='int((nf+1)/2) * W/nf * 0.18u' as='int((nf+2)/2) * W/nf * 0.18u'
+ pd='2*int((nf+1)/2) * (W/nf + 0.18u)' ps='2*int((nf+2)/2) * (W/nf + 0.18u)' nrd='0.18u / W' nrs='0.18u / W' sa=0 sb=0 sd=0
XM1 fn_p vin_p net_tail vss nfet_03v3 L=0.28u W=6.00u nf=2 ad='int((nf+1)/2) * W/nf * 0.18u' as='int((nf+2)/2) * W/nf * 0.18u' pd='2*int((nf+1)/2) * (W/nf + 0.18u)'
+ ps='2*int((nf+2)/2) * (W/nf + 0.18u)' nrd='0.18u / W' nrs='0.18u / W' sa=0 sb=0 sd=0
XM2 fn_n vin_n net_tail vss nfet_03v3 L=0.28u W=6.00u nf=2 ad='int((nf+1)/2) * W/nf * 0.18u' as='int((nf+2)/2) * W/nf * 0.18u' pd='2*int((nf+1)/2) * (W/nf + 0.18u)'
+ ps='2*int((nf+2)/2) * (W/nf + 0.18u)' nrd='0.18u / W' nrs='0.18u / W' sa=0 sb=0 sd=0
XM3 out_p out_n fn_p vss nfet_03v3 L=0.28u W=3.50u nf=1 ad='int((nf+1)/2) * W/nf * 0.18u' as='int((nf+2)/2) * W/nf * 0.18u' pd='2*int((nf+1)/2) * (W/nf + 0.18u)'
+ ps='2*int((nf+2)/2) * (W/nf + 0.18u)' nrd='0.18u / W' nrs='0.18u / W' sa=0 sb=0 sd=0
XM4 out_n out_p fn_n vss nfet_03v3 L=0.28u W=3.50u nf=1 ad='int((nf+1)/2) * W/nf * 0.18u' as='int((nf+2)/2) * W/nf * 0.18u' pd='2*int((nf+1)/2) * (W/nf + 0.18u)'
+ ps='2*int((nf+2)/2) * (W/nf + 0.18u)' nrd='0.18u / W' nrs='0.18u / W' sa=0 sb=0 sd=0
XM5 out_p out_n vdd vdd pfet_03v3 L=0.28u W=4.20u nf=2 ad='int((nf+1)/2) * W/nf * 0.18u' as='int((nf+2)/2) * W/nf * 0.18u' pd='2*int((nf+1)/2) * (W/nf + 0.18u)'
+ ps='2*int((nf+2)/2) * (W/nf + 0.18u)' nrd='0.18u / W' nrs='0.18u / W' sa=0 sb=0 sd=0
XM6 out_n out_p vdd vdd pfet_03v3 L=0.28u W=4.20u nf=2 ad='int((nf+1)/2) * W/nf * 0.18u' as='int((nf+2)/2) * W/nf * 0.18u' pd='2*int((nf+1)/2) * (W/nf + 0.18u)'
+ ps='2*int((nf+2)/2) * (W/nf + 0.18u)' nrd='0.18u / W' nrs='0.18u / W' sa=0 sb=0 sd=0
XM7 out_p rst_latch vdd vdd pfet_03v3 L=0.28u W=2.00u nf=1 ad='int((nf+1)/2) * W/nf * 0.18u' as='int((nf+2)/2) * W/nf * 0.18u' pd='2*int((nf+1)/2) * (W/nf + 0.18u)'
+ ps='2*int((nf+2)/2) * (W/nf + 0.18u)' nrd='0.18u / W' nrs='0.18u / W' sa=0 sb=0 sd=0
XM8 out_n rst_latch vdd vdd pfet_03v3 L=0.28u W=2.00u nf=1 ad='int((nf+1)/2) * W/nf * 0.18u' as='int((nf+2)/2) * W/nf * 0.18u' pd='2*int((nf+1)/2) * (W/nf + 0.18u)'
+ ps='2*int((nf+2)/2) * (W/nf + 0.18u)' nrd='0.18u / W' nrs='0.18u / W' sa=0 sb=0 sd=0
XM9 fn_p rst_latch vdd vdd pfet_03v3 L=0.28u W=2.00u nf=1 ad='int((nf+1)/2) * W/nf * 0.18u' as='int((nf+2)/2) * W/nf * 0.18u' pd='2*int((nf+1)/2) * (W/nf + 0.18u)'
+ ps='2*int((nf+2)/2) * (W/nf + 0.18u)' nrd='0.18u / W' nrs='0.18u / W' sa=0 sb=0 sd=0
XM10 fn_n rst_latch vdd vdd pfet_03v3 L=0.28u W=2.00u nf=1 ad='int((nf+1)/2) * W/nf * 0.18u' as='int((nf+2)/2) * W/nf * 0.18u' pd='2*int((nf+1)/2) * (W/nf + 0.18u)'
+ ps='2*int((nf+2)/2) * (W/nf + 0.18u)' nrd='0.18u / W' nrs='0.18u / W' sa=0 sb=0 sd=0
.ends


* expanding   symbol:  sar_adc/blocks/comparator/comp_inv_3v3.sym # of pins=4
** sym_path: /foss/designs/chipathon26-SAR_ADC/xschem/sar_adc/blocks/comparator/comp_inv_3v3.sym
** sch_path: /foss/designs/chipathon26-SAR_ADC/xschem/sar_adc/blocks/comparator/comp_inv_3v3.sch
.subckt comp_inv_3v3 vi vo vdd vss
*.ipin vi
*.opin vo
*.iopin vdd
*.iopin vss
XM2 vo vi vdd vdd pfet_03v3 L=0.28u W=4.00u nf=1 ad='int((nf+1)/2) * W/nf * 0.18u' as='int((nf+2)/2) * W/nf * 0.18u' pd='2*int((nf+1)/2) * (W/nf + 0.18u)'
+ ps='2*int((nf+2)/2) * (W/nf + 0.18u)' nrd='0.18u / W' nrs='0.18u / W' sa=0 sb=0 sd=0
XM1 vo vi vss vss nfet_03v3 L=0.28u W=1.60u nf=1 ad='int((nf+1)/2) * W/nf * 0.18u' as='int((nf+2)/2) * W/nf * 0.18u' pd='2*int((nf+1)/2) * (W/nf + 0.18u)'
+ ps='2*int((nf+2)/2) * (W/nf + 0.18u)' nrd='0.18u / W' nrs='0.18u / W' sa=0 sb=0 sd=0
.ends


* expanding   symbol:  sar_adc/blocks/comparator/comp_xor_fast.sym # of pins=5
** sym_path: /foss/designs/chipathon26-SAR_ADC/xschem/sar_adc/blocks/comparator/comp_xor_fast.sym
** sch_path: /foss/designs/chipathon26-SAR_ADC/xschem/sar_adc/blocks/comparator/comp_xor_fast.sch
.subckt comp_xor_fast a b y vdd vss
*.ipin a
*.ipin b
*.opin y
*.iopin vdd
*.iopin vss
x1 vdd vss a nab b async_nand2
x2 vdd vss a a_nab nab async_nand2
x3 vdd vss b b_nab nab async_nand2
x4 vdd vss a_nab y b_nab async_nand2
.ends


* expanding   symbol:  sar_adc/blocks/async_sar/async_inverter.sym # of pins=4
** sym_path: /foss/designs/chipathon26-SAR_ADC/xschem/sar_adc/blocks/async_sar/async_inverter.sym
** sch_path: /foss/designs/chipathon26-SAR_ADC/xschem/sar_adc/blocks/async_sar/async_inverter.sch
.subckt async_inverter vdd input out vss
*.ipin input
*.opin out
*.iopin vdd
*.iopin vss
XM5 out input vdd vdd pfet_03v3 L=0.28u W=1.00u nf=1 ad='int((nf+1)/2) * W/nf * 0.18u' as='int((nf+2)/2) * W/nf * 0.18u' pd='2*int((nf+1)/2) * (W/nf + 0.18u)'
+ ps='2*int((nf+2)/2) * (W/nf + 0.18u)' nrd='0.18u / W' nrs='0.18u / W' sa=0 sb=0 sd=0
XM6 out input vss vss nfet_03v3 L=0.28u W=0.50u nf=1 ad='int((nf+1)/2) * W/nf * 0.18u' as='int((nf+2)/2) * W/nf * 0.18u' pd='2*int((nf+1)/2) * (W/nf + 0.18u)'
+ ps='2*int((nf+2)/2) * (W/nf + 0.18u)' nrd='0.18u / W' nrs='0.18u / W' sa=0 sb=0 sd=0
.ends


* expanding   symbol:  sar_adc/blocks/async_sar/shift_reg_8bit.sym # of pins=14
** sym_path: /foss/designs/chipathon26-SAR_ADC/xschem/sar_adc/blocks/async_sar/shift_reg_8bit.sym
** sch_path: /foss/designs/chipathon26-SAR_ADC/xschem/sar_adc/blocks/async_sar/shift_reg_8bit.sch
.subckt shift_reg_8bit vdd vss Q0 Q1 Q2 Q3 Q4 Q5 Q6 Q7 done serial_in clk rst_n
*.ipin serial_in
*.ipin clk
*.ipin rst_n
*.opin Q0
*.opin Q1
*.opin Q2
*.opin Q3
*.opin Q4
*.opin Q5
*.opin Q6
*.opin Q7
*.opin done
*.iopin vdd
*.iopin vss
x1 vdd vss Q0 serial_in clk rst_n dff_cell_set
x2 Q0 clk vdd vss rst_n Q1 dff_cell
x3 Q1 clk vdd vss rst_n Q2 dff_cell
x4 Q2 clk vdd vss rst_n Q3 dff_cell
x5 Q3 clk vdd vss rst_n Q4 dff_cell
x6 Q4 clk vdd vss rst_n Q5 dff_cell
x7 Q5 clk vdd vss rst_n Q6 dff_cell
x8 Q6 clk vdd vss rst_n Q7 dff_cell
x9 Q7 clk vdd vss rst_n done dff_cell
.ends


* expanding   symbol:  sar_adc/blocks/async_sar/bit_reg.sym # of pins=6
** sym_path: /foss/designs/chipathon26-SAR_ADC/xschem/sar_adc/blocks/async_sar/bit_reg.sym
** sch_path: /foss/designs/chipathon26-SAR_ADC/xschem/sar_adc/blocks/async_sar/bit_reg.sch
.subckt bit_reg vdd vss bit_out comp_out en rst_n
*.ipin comp_out
*.ipin en
*.ipin rst_n
*.opin bit_out
*.iopin vdd
*.iopin vss
x_nand_set vdd vss comp_out set_n en async_nand2
x_inv_set vdd set_n set vss async_inverter
x_inv_rst vdd rst_n rst vss async_inverter
x_nor_q rst bit_out_bar bit_out vdd vss async_nor2
x_nor_qb set bit_out bit_out_bar vdd vss async_nor2
.ends


* expanding   symbol:  sar_adc/blocks/async_sar/async_nor2.sym # of pins=5
** sym_path: /foss/designs/chipathon26-SAR_ADC/xschem/sar_adc/blocks/async_sar/async_nor2.sym
** sch_path: /foss/designs/chipathon26-SAR_ADC/xschem/sar_adc/blocks/async_sar/async_nor2.sch
.subckt async_nor2 A B Y vdd vss
*.ipin A
*.ipin B
*.opin Y
*.iopin vdd
*.iopin vss
x1 vdd A A_b vss async_inverter
x2 vdd B B_b vss async_inverter
x3 vdd vss A_b net1 B_b async_nand2
x4 vdd net1 Y vss async_inverter
.ends


* expanding   symbol:  sar_adc/blocks/async_sar/async_pulse_settle.sym # of pins=4
** sym_path: /foss/designs/chipathon26-SAR_ADC/xschem/sar_adc/blocks/async_sar/async_pulse_settle.sym
** sch_path: /foss/designs/chipathon26-SAR_ADC/xschem/sar_adc/blocks/async_sar/async_pulse_settle.sch
.subckt async_pulse_settle vdd vss in out
*.ipin in
*.iopin vdd
*.iopin vss
*.opin out
x_inv vdd in in_inv vss async_inverter
x_del vdd vss in in_del_n async_delay_chain
x_nand vdd vss in_inv out in_del_n async_nand2
.ends


* expanding   symbol:  sar_adc/blocks/async_sar/async_start_delay.sym # of pins=4
** sym_path: /foss/designs/chipathon26-SAR_ADC/xschem/sar_adc/blocks/async_sar/async_start_delay.sym
** sch_path: /foss/designs/chipathon26-SAR_ADC/xschem/sar_adc/blocks/async_sar/async_start_delay.sch
.subckt async_start_delay vdd vss in out
*.ipin in
*.iopin vdd
*.iopin vss
*.opin out
x1 vdd in net1 vss async_inverter
x2 vdd net1 net2 vss async_inverter
x3 vdd net2 net3 vss async_inverter
x4 vdd net3 net4 vss async_inverter
x5 vdd net4 net5 vss async_inverter
x6 vdd net5 net6 vss async_inverter
x7 vdd net6 net7 vss async_inverter
x8 vdd net7 net8 vss async_inverter
x9 vdd net8 net9 vss async_inverter
x10 vdd net9 net10 vss async_inverter
x11 vdd net10 net11 vss async_inverter
x12 vdd net11 net12 vss async_inverter
x13 vdd net12 net13 vss async_inverter
x14 vdd net13 net14 vss async_inverter
x15 vdd net14 net15 vss async_inverter
x16 vdd net15 net16 vss async_inverter
x17 vdd net16 net17 vss async_inverter
x18 vdd net17 net18 vss async_inverter
x19 vdd net18 net19 vss async_inverter
x20 vdd net19 net20 vss async_inverter
x21 vdd net20 net21 vss async_inverter
x22 vdd net21 net22 vss async_inverter
x23 vdd net22 net23 vss async_inverter
x24 vdd net23 net24 vss async_inverter
x25 vdd net24 net25 vss async_inverter
x26 vdd net25 net26 vss async_inverter
x27 vdd net26 net27 vss async_inverter
x28 vdd net27 net28 vss async_inverter
x29 vdd net28 net29 vss async_inverter
x30 vdd net29 net30 vss async_inverter
x31 vdd net30 net31 vss async_inverter
x32 vdd net31 net32 vss async_inverter
x33 vdd net32 net33 vss async_inverter
x34 vdd net33 net34 vss async_inverter
x35 vdd net34 net35 vss async_inverter
x36 vdd net35 net36 vss async_inverter
x37 vdd net36 net37 vss async_inverter
x38 vdd net37 net38 vss async_inverter
x39 vdd net38 net39 vss async_inverter
x40 vdd net39 net40 vss async_inverter
x41 vdd net40 net41 vss async_inverter
x42 vdd net41 net42 vss async_inverter
x43 vdd net42 net43 vss async_inverter
x44 vdd net43 net44 vss async_inverter
x45 vdd net44 out vss async_inverter
XC_start_tune out vss cap_mim_2f0fF c_width=8.66e-6 c_length=8.66e-6
.ends


* expanding   symbol:  sar_adc/blocks/async_sar/async_nand2.sym # of pins=5
** sym_path: /foss/designs/chipathon26-SAR_ADC/xschem/sar_adc/blocks/async_sar/async_nand2.sym
** sch_path: /foss/designs/chipathon26-SAR_ADC/xschem/sar_adc/blocks/async_sar/async_nand2.sch
.subckt async_nand2 vdd vss input_A output input_B
*.ipin input_A
*.ipin input_B
*.opin output
*.iopin vdd
*.iopin vss
XM2 net1 input_B vss vss nfet_03v3 L=0.28u W=0.50u nf=1 ad='int((nf+1)/2) * W/nf * 0.18u' as='int((nf+2)/2) * W/nf * 0.18u' pd='2*int((nf+1)/2) * (W/nf + 0.18u)'
+ ps='2*int((nf+2)/2) * (W/nf + 0.18u)' nrd='0.18u / W' nrs='0.18u / W' sa=0 sb=0 sd=0
XM3 output input_A vdd vdd pfet_03v3 L=0.28u W=1.0u nf=1 ad='int((nf+1)/2) * W/nf * 0.18u' as='int((nf+2)/2) * W/nf * 0.18u' pd='2*int((nf+1)/2) * (W/nf + 0.18u)'
+ ps='2*int((nf+2)/2) * (W/nf + 0.18u)' nrd='0.18u / W' nrs='0.18u / W' sa=0 sb=0 sd=0
XM1 output input_B vdd vdd pfet_03v3 L=0.28u W=1.0u nf=1 ad='int((nf+1)/2) * W/nf * 0.18u' as='int((nf+2)/2) * W/nf * 0.18u' pd='2*int((nf+1)/2) * (W/nf + 0.18u)'
+ ps='2*int((nf+2)/2) * (W/nf + 0.18u)' nrd='0.18u / W' nrs='0.18u / W' sa=0 sb=0 sd=0
XM4 output input_A net1 vss nfet_03v3 L=0.28u W=0.50u nf=1 ad='int((nf+1)/2) * W/nf * 0.18u' as='int((nf+2)/2) * W/nf * 0.18u' pd='2*int((nf+1)/2) * (W/nf + 0.18u)'
+ ps='2*int((nf+2)/2) * (W/nf + 0.18u)' nrd='0.18u / W' nrs='0.18u / W' sa=0 sb=0 sd=0
.ends


* expanding   symbol:  sar_adc/blocks/async_sar/dff_cell_set.sym # of pins=6
** sym_path: /foss/designs/chipathon26-SAR_ADC/xschem/sar_adc/blocks/async_sar/dff_cell_set.sym
** sch_path: /foss/designs/chipathon26-SAR_ADC/xschem/sar_adc/blocks/async_sar/dff_cell_set.sch
.subckt dff_cell_set vdd vss Q D clk rst_n
*.ipin D
*.ipin clk
*.ipin rst_n
*.opin Q
*.iopin vdd
*.iopin vss
x_inv_d vdd D D_b vss async_inverter
x_dff D_b clk vdd vss rst_n net1 dff_cell
x_inv_q vdd net1 Q vss async_inverter
.ends


* expanding   symbol:  sar_adc/blocks/async_sar/dff_cell.sym # of pins=6
** sym_path: /foss/designs/chipathon26-SAR_ADC/xschem/sar_adc/blocks/async_sar/dff_cell.sym
** sch_path: /foss/designs/chipathon26-SAR_ADC/xschem/sar_adc/blocks/async_sar/dff_cell.sch
.subckt dff_cell D clk vdd vss rst_n Q
*.ipin D
*.ipin clk
*.ipin rst_n
*.opin Q
*.iopin vdd
*.iopin vss
XM1 clk_n clk vdd vdd pfet_03v3 L=0.28u W=1.0u nf=1 ad='int((nf+1)/2) * W/nf * 0.18u' as='int((nf+2)/2) * W/nf * 0.18u' pd='2*int((nf+1)/2) * (W/nf + 0.18u)'
+ ps='2*int((nf+2)/2) * (W/nf + 0.18u)' nrd='0.18u / W' nrs='0.18u / W' sa=0 sb=0 sd=0
XM2 clk_n clk vss vss nfet_03v3 L=0.28u W=0.50u nf=1 ad='int((nf+1)/2) * W/nf * 0.18u' as='int((nf+2)/2) * W/nf * 0.18u' pd='2*int((nf+1)/2) * (W/nf + 0.18u)'
+ ps='2*int((nf+2)/2) * (W/nf + 0.18u)' nrd='0.18u / W' nrs='0.18u / W' sa=0 sb=0 sd=0
XM3 M clk_n D_int vdd pfet_03v3 L=0.28u W=1.0u nf=1 ad='int((nf+1)/2) * W/nf * 0.18u' as='int((nf+2)/2) * W/nf * 0.18u' pd='2*int((nf+1)/2) * (W/nf + 0.18u)'
+ ps='2*int((nf+2)/2) * (W/nf + 0.18u)' nrd='0.18u / W' nrs='0.18u / W' sa=0 sb=0 sd=0
XM4 D_int clk M vss nfet_03v3 L=0.28u W=0.50u nf=1 ad='int((nf+1)/2) * W/nf * 0.18u' as='int((nf+2)/2) * W/nf * 0.18u' pd='2*int((nf+1)/2) * (W/nf + 0.18u)'
+ ps='2*int((nf+2)/2) * (W/nf + 0.18u)' nrd='0.18u / W' nrs='0.18u / W' sa=0 sb=0 sd=0
XM5 M_bar M vdd vdd pfet_03v3 L=0.28u W=1.0u nf=1 ad='int((nf+1)/2) * W/nf * 0.18u' as='int((nf+2)/2) * W/nf * 0.18u' pd='2*int((nf+1)/2) * (W/nf + 0.18u)'
+ ps='2*int((nf+2)/2) * (W/nf + 0.18u)' nrd='0.18u / W' nrs='0.18u / W' sa=0 sb=0 sd=0
XM6 M_bar M vss vss nfet_03v3 L=0.28u W=0.50u nf=1 ad='int((nf+1)/2) * W/nf * 0.18u' as='int((nf+2)/2) * W/nf * 0.18u' pd='2*int((nf+1)/2) * (W/nf + 0.18u)'
+ ps='2*int((nf+2)/2) * (W/nf + 0.18u)' nrd='0.18u / W' nrs='0.18u / W' sa=0 sb=0 sd=0
XM7 M M_bar vdd vdd pfet_03v3 L=2.0u W=0.42u nf=1 ad='int((nf+1)/2) * W/nf * 0.18u' as='int((nf+2)/2) * W/nf * 0.18u' pd='2*int((nf+1)/2) * (W/nf + 0.18u)'
+ ps='2*int((nf+2)/2) * (W/nf + 0.18u)' nrd='0.18u / W' nrs='0.18u / W' sa=0 sb=0 sd=0
XM8 M M_bar vss vss nfet_03v3 L=2.4u W=0.42u nf=1 ad='int((nf+1)/2) * W/nf * 0.18u' as='int((nf+2)/2) * W/nf * 0.18u' pd='2*int((nf+1)/2) * (W/nf + 0.18u)'
+ ps='2*int((nf+2)/2) * (W/nf + 0.18u)' nrd='0.18u / W' nrs='0.18u / W' sa=0 sb=0 sd=0
XM9 S clk M_bar vdd pfet_03v3 L=0.28u W=1.0u nf=1 ad='int((nf+1)/2) * W/nf * 0.18u' as='int((nf+2)/2) * W/nf * 0.18u' pd='2*int((nf+1)/2) * (W/nf + 0.18u)'
+ ps='2*int((nf+2)/2) * (W/nf + 0.18u)' nrd='0.18u / W' nrs='0.18u / W' sa=0 sb=0 sd=0
XM10 M_bar clk_n S vss nfet_03v3 L=0.28u W=0.50u nf=1 ad='int((nf+1)/2) * W/nf * 0.18u' as='int((nf+2)/2) * W/nf * 0.18u' pd='2*int((nf+1)/2) * (W/nf + 0.18u)'
+ ps='2*int((nf+2)/2) * (W/nf + 0.18u)' nrd='0.18u / W' nrs='0.18u / W' sa=0 sb=0 sd=0
XM11 Q_bar S vdd vdd pfet_03v3 L=0.28u W=1.0u nf=1 ad='int((nf+1)/2) * W/nf * 0.18u' as='int((nf+2)/2) * W/nf * 0.18u' pd='2*int((nf+1)/2) * (W/nf + 0.18u)'
+ ps='2*int((nf+2)/2) * (W/nf + 0.18u)' nrd='0.18u / W' nrs='0.18u / W' sa=0 sb=0 sd=0
XM12 Q_bar rst_n vdd vdd pfet_03v3 L=0.28u W=1.0u nf=1 ad='int((nf+1)/2) * W/nf * 0.18u' as='int((nf+2)/2) * W/nf * 0.18u' pd='2*int((nf+1)/2) * (W/nf + 0.18u)'
+ ps='2*int((nf+2)/2) * (W/nf + 0.18u)' nrd='0.18u / W' nrs='0.18u / W' sa=0 sb=0 sd=0
XM13 Q_bar S net1 vss nfet_03v3 L=0.28u W=0.50u nf=1 ad='int((nf+1)/2) * W/nf * 0.18u' as='int((nf+2)/2) * W/nf * 0.18u' pd='2*int((nf+1)/2) * (W/nf + 0.18u)'
+ ps='2*int((nf+2)/2) * (W/nf + 0.18u)' nrd='0.18u / W' nrs='0.18u / W' sa=0 sb=0 sd=0
XM14 net1 rst_n vss vss nfet_03v3 L=0.28u W=0.50u nf=1 ad='int((nf+1)/2) * W/nf * 0.18u' as='int((nf+2)/2) * W/nf * 0.18u' pd='2*int((nf+1)/2) * (W/nf + 0.18u)'
+ ps='2*int((nf+2)/2) * (W/nf + 0.18u)' nrd='0.18u / W' nrs='0.18u / W' sa=0 sb=0 sd=0
XM15 Q Q_bar vdd vdd pfet_03v3 L=0.28u W=1.0u nf=1 ad='int((nf+1)/2) * W/nf * 0.18u' as='int((nf+2)/2) * W/nf * 0.18u' pd='2*int((nf+1)/2) * (W/nf + 0.18u)'
+ ps='2*int((nf+2)/2) * (W/nf + 0.18u)' nrd='0.18u / W' nrs='0.18u / W' sa=0 sb=0 sd=0
XM16 Q Q_bar vss vss nfet_03v3 L=0.28u W=0.50u nf=1 ad='int((nf+1)/2) * W/nf * 0.18u' as='int((nf+2)/2) * W/nf * 0.18u' pd='2*int((nf+1)/2) * (W/nf + 0.18u)'
+ ps='2*int((nf+2)/2) * (W/nf + 0.18u)' nrd='0.18u / W' nrs='0.18u / W' sa=0 sb=0 sd=0
XM17 S Q_bar vdd vdd pfet_03v3 L=2.0u W=0.42u nf=1 ad='int((nf+1)/2) * W/nf * 0.18u' as='int((nf+2)/2) * W/nf * 0.18u' pd='2*int((nf+1)/2) * (W/nf + 0.18u)'
+ ps='2*int((nf+2)/2) * (W/nf + 0.18u)' nrd='0.18u / W' nrs='0.18u / W' sa=0 sb=0 sd=0
XM18 S Q_bar vss vss nfet_03v3 L=2.4u W=0.42u nf=1 ad='int((nf+1)/2) * W/nf * 0.18u' as='int((nf+2)/2) * W/nf * 0.18u' pd='2*int((nf+1)/2) * (W/nf + 0.18u)'
+ ps='2*int((nf+2)/2) * (W/nf + 0.18u)' nrd='0.18u / W' nrs='0.18u / W' sa=0 sb=0 sd=0
XM19 D_int D vdd vdd pfet_03v3 L=0.28u W=1.0u nf=1 ad='int((nf+1)/2) * W/nf * 0.18u' as='int((nf+2)/2) * W/nf * 0.18u' pd='2*int((nf+1)/2) * (W/nf + 0.18u)'
+ ps='2*int((nf+2)/2) * (W/nf + 0.18u)' nrd='0.18u / W' nrs='0.18u / W' sa=0 sb=0 sd=0
XM20 D_int D vss vss nfet_03v3 L=0.28u W=0.50u nf=1 ad='int((nf+1)/2) * W/nf * 0.18u' as='int((nf+2)/2) * W/nf * 0.18u' pd='2*int((nf+1)/2) * (W/nf + 0.18u)'
+ ps='2*int((nf+2)/2) * (W/nf + 0.18u)' nrd='0.18u / W' nrs='0.18u / W' sa=0 sb=0 sd=0
.ends


* expanding   symbol:  sar_adc/blocks/async_sar/async_delay_chain.sym # of pins=4
** sym_path: /foss/designs/chipathon26-SAR_ADC/xschem/sar_adc/blocks/async_sar/async_delay_chain.sym
** sch_path: /foss/designs/chipathon26-SAR_ADC/xschem/sar_adc/blocks/async_sar/async_delay_chain.sch
.subckt async_delay_chain vdd vss in out
*.ipin in
*.iopin vdd
*.iopin vss
*.opin out
x1 vdd in net1 vss async_inverter
x2 vdd net1 net2 vss async_inverter
x3 vdd net2 net3 vss async_inverter
x4 vdd net3 net4 vss async_inverter
x5 vdd net4 net5 vss async_inverter
x6 vdd net5 net6 vss async_inverter
x7 vdd net6 net7 vss async_inverter
x8 vdd net7 net8 vss async_inverter
x9 vdd net8 net9 vss async_inverter
x10 vdd net9 net10 vss async_inverter
x11 vdd net10 net11 vss async_inverter
x12 vdd net11 net12 vss async_inverter
x13 vdd net12 net13 vss async_inverter
x14 vdd net13 net14 vss async_inverter
x15 vdd net14 net15 vss async_inverter
x16 vdd net15 net16 vss async_inverter
x17 vdd net16 net17 vss async_inverter
x18 vdd net17 net18 vss async_inverter
x19 vdd net18 net19 vss async_inverter
x20 vdd net19 net20 vss async_inverter
x21 vdd net20 out vss async_inverter
.ends

.end
