KyriePakpahan/chipathon26-SAR_ADC/cdl/async_pulse_settle.spice

.include async_inverter.spice
.include async_delay_chain.spice
.include async_nand2.spice

.subckt async_pulse_settle VDD VSS in out
x_inv VDD VSS in in_inv async_inverter
x_del VDD VSS in in_del_n async_delay_chain
x_nand VDD VSS in_inv in_del_n out async_nand2
.ends
