KyriePakpahan/chipathon26-SAR_ADC/netlist/sar_adc_chip_pex.spice

* NGSPICE file created from sar_adc_chip.ext - technology: gf180mcuD

.subckt async_sar start comp_out_p comp_done sample_en rst_latch done dout[0] dac_in[0]
+ dout[1] dac_in[1] dout[2] dac_in[2] dout[3] dac_in[3] dout[4] dac_in[4] dout[5]
+ dac_in[5] dout[6] dac_in[6] dout[7] dac_in[7] a_4108_41600# a_36908_54400# a_37028_9464#
+ a_30228_54264# a_34108_29600# a_5708_10960# a_35308_41600# a_38108_54400# a_7708_46000#
+ a_20908_46000# a_37028_54264# a_36908_12400# a_47028_19064# a_33308_24800# a_8108_15760#
+ a_34108_41600# a_2908_33600# a_36908_1200# a_38108_12400# a_5708_6160# a_23428_54264#
+ a_5708_15760# a_38108_6800# a_2228_20424# a_50628_54264# a_2908_37600# a_33308_19200#
+ a_16628_54264# a_34108_33600# a_7708_41600# a_38908_41600# a_8108_6160# a_2228_10824#
+ a_38228_3864# a_43828_54264# a_8108_20560# a_5708_20560# a_36908_6800# a_34108_37600#
+ a_2908_29600# a_36908_50400# a_38108_1200# a_9828_54264# a_37028_3864# a_38228_9464#
+ a_2228_15624# a_38108_50400# a_35308_29600# a_3428_1424# a_2908_41600# a_3028_54264#
+ a_8108_10960# a_2228_6024#
X0 start a_2908_50400# a_3028_54264# start pfet_03v3 ad=1.38p pd=4.76u as=0.65p ps=3.3u w=1u l=0.28u
X1 start a_50908_41600# dout[7] start pfet_03v3 ad=1.104p pd=4.36u as=0.52p ps=2.9u w=0.8u l=0.28u
X2 start a_42908_12400# a_44108_12400# start pfet_03v3 ad=1.38p pd=4.76u as=0.65p ps=3.3u w=1u l=0.28u
X3 start comp_done a_33308_19200# start pfet_03v3 ad=1.38p pd=4.76u as=0.65p ps=3.3u w=1u l=0.28u
X4 start a_9308_10960# a_11708_10960# start nfet_03v3 ad=0.66p pd=3.64u as=0.305p ps=2.22u w=0.5u l=0.28u
X5 start a_6508_46000# a_7708_46000# start nfet_03v3 ad=0.66p pd=3.64u as=0.305p ps=2.22u w=0.5u l=0.28u
X6 start a_16228_10824# a_16108_10960# start nfet_03v3 ad=0.66p pd=3.64u as=0.305p ps=2.22u w=0.5u l=0.28u
X7 a_12694_28400# a_10108_29600# a_12508_29600# start nfet_03v3 ad=0.305p pd=2.22u as=0.305p ps=2.22u w=0.5u l=0.28u
X8 start a_44108_1200# a_45308_1200# start nfet_03v3 ad=0.66p pd=3.64u as=0.305p ps=2.22u w=0.5u l=0.28u
X9 start dout[5] a_42508_33600# start nfet_03v3 ad=0.577p pd=3.52u as=0.2646p ps=2.1u w=0.42u l=0.28u
X10 start a_48908_1200# a_50108_1200# start pfet_03v3 ad=1.38p pd=4.76u as=0.65p ps=3.3u w=1u l=0.28u
X11 start a_37028_9464# a_35828_9464# start nfet_03v3 ad=0.66p pd=3.64u as=0.305p ps=2.22u w=0.5u l=0.28u
X12 start a_20908_46000# a_39708_24800# start pfet_03v3 ad=1.104p pd=4.36u as=0.52p ps=2.9u w=0.8u l=0.28u
X13 start a_9308_20560# a_11708_20560# start pfet_03v3 ad=1.38p pd=4.76u as=0.65p ps=3.3u w=1u l=0.28u
X14 start a_53708_6800# a_54908_6800# start pfet_03v3 ad=1.38p pd=4.76u as=0.65p ps=3.3u w=1u l=0.28u
X15 start a_46508_12400# a_47708_12400# start nfet_03v3 ad=0.66p pd=3.64u as=0.305p ps=2.22u w=0.5u l=0.28u
X16 start comp_out_p a_24508_50400# start pfet_03v3 ad=1.104p pd=4.36u as=0.52p ps=2.9u w=0.8u l=0.28u
X17 start a_48508_37600# a_50908_37600# start pfet_03v3 ad=1.38p pd=4.76u as=0.65p ps=3.3u w=1u l=0.28u
X18 start a_25828_1224# a_24508_1360# start pfet_03v3 ad=1.38p pd=4.76u as=0.65p ps=3.3u w=1u l=0.28u
X19 start a_10908_50400# a_9828_54264# start pfet_03v3 ad=1.38p pd=4.76u as=0.65p ps=3.3u w=1u l=0.28u
X20 start a_10628_15624# a_9494_14400# start nfet_03v3 ad=0.66p pd=3.64u as=0.305p ps=2.22u w=0.5u l=0.28u
X21 a_5708_10960# a_2228_10824# a_8108_10960# start pfet_03v3 ad=0.65p pd=3.3u as=0.65p ps=3.3u w=1u l=0.28u
X22 start a_44908_54400# a_46294_53200# start nfet_03v3 ad=0.66p pd=3.64u as=0.305p ps=2.22u w=0.5u l=0.28u
X23 start a_20908_1360# a_19708_1360# start nfet_03v3 ad=0.577p pd=3.52u as=0.2646p ps=2.1u w=0.42u l=2.4u
X24 start a_52628_15064# a_51428_15064# start nfet_03v3 ad=0.66p pd=3.64u as=0.305p ps=2.22u w=0.5u l=0.28u
X25 start a_34508_1200# a_35708_1200# start nfet_03v3 ad=0.66p pd=3.64u as=0.305p ps=2.22u w=0.5u l=0.28u
X26 start a_10108_41600# a_12508_41600# start pfet_03v3 ad=1.38p pd=4.76u as=0.65p ps=3.3u w=1u l=0.28u
X27 start sample_en a_46628_3864# start nfet_03v3 ad=0.66p pd=3.64u as=0.305p ps=2.22u w=0.5u l=0.28u
X28 start a_46628_3864# a_45428_3864# start pfet_03v3 ad=1.38p pd=4.76u as=0.65p ps=3.3u w=1u l=0.28u
X29 a_9494_14400# a_8108_15760# a_9308_15760# start nfet_03v3 ad=0.305p pd=2.22u as=0.305p ps=2.22u w=0.5u l=0.28u
X30 start a_9828_54264# a_9708_54400# start nfet_03v3 ad=0.577p pd=3.52u as=0.2646p ps=2.1u w=0.42u l=0.28u
X31 start a_50108_6800# a_51308_6800# start nfet_03v3 ad=0.66p pd=3.64u as=0.305p ps=2.22u w=0.5u l=0.28u
X32 start a_18508_37600# a_19894_36400# start nfet_03v3 ad=0.66p pd=3.64u as=0.305p ps=2.22u w=0.5u l=0.28u
X33 start a_2228_6024# a_2108_6160# start nfet_03v3 ad=0.66p pd=3.64u as=0.305p ps=2.22u w=0.5u l=0.28u
X34 a_51094_40400# a_48508_41600# a_50908_41600# start nfet_03v3 ad=0.305p pd=2.22u as=0.305p ps=2.22u w=0.5u l=0.28u
X35 start a_22108_6160# a_24508_6160# start pfet_03v3 ad=1.38p pd=4.76u as=0.65p ps=3.3u w=1u l=0.28u
X36 start a_39308_6800# a_40508_6800# start pfet_03v3 ad=1.38p pd=4.76u as=0.65p ps=3.3u w=1u l=0.28u
X37 start a_16228_10824# a_16108_10960# start pfet_03v3 ad=1.38p pd=4.76u as=0.65p ps=3.3u w=1u l=0.28u
X38 start comp_out_p a_44908_50400# start nfet_03v3 ad=0.577p pd=3.52u as=0.2646p ps=2.1u w=0.42u l=0.28u
X39 start a_9308_15760# a_11708_15760# start pfet_03v3 ad=1.38p pd=4.76u as=0.65p ps=3.3u w=1u l=0.28u
X40 start a_41308_37600# a_43708_37600# start pfet_03v3 ad=1.38p pd=4.76u as=0.65p ps=3.3u w=1u l=0.28u
X41 start a_2908_37600# a_10108_37600# start pfet_03v3 ad=1.104p pd=4.36u as=0.52p ps=2.9u w=0.8u l=0.28u
X42 a_16108_15760# a_15028_15624# a_17308_15760# start nfet_03v3 ad=0.305p pd=2.22u as=0.305p ps=2.22u w=0.5u l=0.28u
X43 start a_53708_1200# a_54908_1200# start pfet_03v3 ad=1.38p pd=4.76u as=0.65p ps=3.3u w=1u l=0.28u
X44 start start a_17708_54400# start nfet_03v3 ad=0.577p pd=3.52u as=0.2646p ps=2.1u w=0.42u l=0.28u
X45 start a_17308_29600# a_19708_29600# start pfet_03v3 ad=1.38p pd=4.76u as=0.65p ps=3.3u w=1u l=0.28u
X46 start a_47828_9464# a_46628_9464# start nfet_03v3 ad=0.66p pd=3.64u as=0.305p ps=2.22u w=0.5u l=0.28u
X47 start a_2908_46000# a_4108_46000# start pfet_03v3 ad=1.38p pd=4.76u as=0.65p ps=3.3u w=1u l=0.28u
X48 start a_19708_46000# a_20908_46000# start nfet_03v3 ad=0.66p pd=3.64u as=0.305p ps=2.22u w=0.5u l=0.28u
X49 start dout[5] a_49708_33600# start pfet_03v3 ad=1.104p pd=4.36u as=0.52p ps=2.9u w=0.8u l=0.28u
X50 start a_50508_54400# dac_in[7] start pfet_03v3 ad=1.38p pd=4.76u as=0.65p ps=3.3u w=1u l=0.28u
X51 start a_11308_37600# a_12694_36400# start nfet_03v3 ad=0.66p pd=3.64u as=0.305p ps=2.22u w=0.5u l=0.28u
X52 start comp_out_p comp_out_p start nfet_03v3 ad=0.66p pd=3.64u as=0.305p ps=2.22u w=0.5u l=0.28u
X53 a_43894_40400# a_41308_41600# a_43708_41600# start nfet_03v3 ad=0.305p pd=2.22u as=0.305p ps=2.22u w=0.5u l=0.28u
X54 start a_59828_15064# a_58628_15064# start pfet_03v3 ad=1.38p pd=4.76u as=0.65p ps=3.3u w=1u l=0.28u
X55 start a_33308_12400# a_34508_12400# start nfet_03v3 ad=0.66p pd=3.64u as=0.305p ps=2.22u w=0.5u l=0.28u
X56 start start a_30228_54264# start pfet_03v3 ad=1.38p pd=4.76u as=0.65p ps=3.3u w=1u l=0.28u
X57 start a_2908_41600# a_10108_41600# start nfet_03v3 ad=0.577p pd=3.52u as=0.2646p ps=2.1u w=0.42u l=0.28u
X58 start a_54908_6800# a_56108_6800# start nfet_03v3 ad=0.66p pd=3.64u as=0.305p ps=2.22u w=0.5u l=0.28u
X59 start start a_4108_54400# start pfet_03v3 ad=1.104p pd=4.36u as=0.52p ps=2.9u w=0.8u l=0.28u
X60 a_19894_32400# a_17308_33600# a_19708_33600# start nfet_03v3 ad=0.305p pd=2.22u as=0.305p ps=2.22u w=0.5u l=0.28u
X61 start a_39308_1200# a_40508_1200# start pfet_03v3 ad=1.38p pd=4.76u as=0.65p ps=3.3u w=1u l=0.28u
X62 start a_5708_6160# a_4508_6160# start nfet_03v3 ad=0.577p pd=3.52u as=0.2646p ps=2.1u w=0.42u l=2.4u
X63 start a_17308_15760# a_18508_15760# start pfet_03v3 ad=1.38p pd=4.76u as=0.65p ps=3.3u w=1u l=0.28u
X64 start a_44108_6800# a_45308_6800# start pfet_03v3 ad=1.38p pd=4.76u as=0.65p ps=3.3u w=1u l=0.28u
X65 start a_12508_46000# a_13708_46000# start nfet_03v3 ad=0.66p pd=3.64u as=0.305p ps=2.22u w=0.5u l=0.28u
X66 start a_47708_12400# a_48908_12400# start pfet_03v3 ad=1.38p pd=4.76u as=0.65p ps=3.3u w=1u l=0.28u
X67 start dac_in[0] dac_in[0] start nfet_03v3 ad=0.577p pd=3.52u as=0.2646p ps=2.1u w=0.42u l=0.28u
X68 start a_34108_37600# a_41308_37600# start nfet_03v3 ad=0.577p pd=3.52u as=0.2646p ps=2.1u w=0.42u l=0.28u
X69 start a_33308_24800# sample_en start pfet_03v3 ad=1.38p pd=4.76u as=0.65p ps=3.3u w=1u l=0.28u
X70 start a_9708_54400# dac_in[1] start pfet_03v3 ad=1.38p pd=4.76u as=0.65p ps=3.3u w=1u l=0.28u
X71 start a_23428_54264# a_23308_54400# start pfet_03v3 ad=1.104p pd=4.36u as=0.52p ps=2.9u w=0.8u l=0.28u
X72 start a_51708_50400# a_53094_49200# start nfet_03v3 ad=0.66p pd=3.64u as=0.305p ps=2.22u w=0.5u l=0.28u
X73 start comp_out_p a_17308_29600# start nfet_03v3 ad=0.577p pd=3.52u as=0.2646p ps=2.1u w=0.42u l=0.28u
X74 start a_3428_1424# start start nfet_03v3 ad=0.305p pd=2.22u as=0.40951n ps=2.30248m w=0.5u l=0.28u
X75 start a_40508_6800# a_41708_6800# start nfet_03v3 ad=0.66p pd=3.64u as=0.305p ps=2.22u w=0.5u l=0.28u
X76 start a_35708_1200# a_36908_1200# start nfet_03v3 ad=0.66p pd=3.64u as=0.305p ps=2.22u w=0.5u l=0.28u
X77 a_5494_49200# a_2908_50400# a_3028_54264# start nfet_03v3 ad=0.305p pd=2.22u as=0.305p ps=2.22u w=0.5u l=0.28u
X78 start a_50108_12400# a_51308_12400# start pfet_03v3 ad=1.38p pd=4.76u as=0.65p ps=3.3u w=1u l=0.28u
X79 start a_57428_15064# a_56228_15064# start nfet_03v3 ad=0.66p pd=3.64u as=0.305p ps=2.22u w=0.5u l=0.28u
X80 start a_35308_29600# comp_out_p start pfet_03v3 ad=1.38p pd=4.76u as=0.65p ps=3.3u w=1u l=0.28u
X81 start a_44108_1200# a_45308_1200# start pfet_03v3 ad=1.38p pd=4.76u as=0.65p ps=3.3u w=1u l=0.28u
X82 start a_7708_41600# a_17308_41600# start pfet_03v3 ad=1.104p pd=4.36u as=0.52p ps=2.9u w=0.8u l=0.28u
X83 start start start start pfet_03v3 ad=0.65p pd=3.3u as=0.40171n ps=2.32842m w=1u l=0.28u
X84 start a_42508_29600# a_43894_28400# start nfet_03v3 ad=0.66p pd=3.64u as=0.305p ps=2.22u w=0.5u l=0.28u
X85 start start start start pfet_03v3 ad=0.65p pd=3.3u as=0 ps=0 w=1u l=0.28u
X86 start a_54908_1200# a_56108_1200# start nfet_03v3 ad=0.66p pd=3.64u as=0.305p ps=2.22u w=0.5u l=0.28u
X87 start a_50228_3864# a_49028_3864# start nfet_03v3 ad=0.66p pd=3.64u as=0.305p ps=2.22u w=0.5u l=0.28u
X88 start a_16508_54400# dac_in[2] start pfet_03v3 ad=1.38p pd=4.76u as=0.65p ps=3.3u w=1u l=0.28u
X89 start sample_en a_35708_24800# start pfet_03v3 ad=1.38p pd=4.76u as=0.65p ps=3.3u w=1u l=0.28u
X90 start a_46628_15064# a_45428_15064# start pfet_03v3 ad=1.38p pd=4.76u as=0.65p ps=3.3u w=1u l=0.28u
X91 start comp_out_p a_24508_50400# start nfet_03v3 ad=0.577p pd=3.52u as=0.2646p ps=2.1u w=0.42u l=0.28u
X92 start a_10908_50400# a_12294_49200# start nfet_03v3 ad=0.66p pd=3.64u as=0.305p ps=2.22u w=0.5u l=0.28u
X93 start a_8908_46000# a_10108_46000# start pfet_03v3 ad=1.38p pd=4.76u as=0.65p ps=3.3u w=1u l=0.28u
X94 start comp_out_p a_48508_37600# start pfet_03v3 ad=1.104p pd=4.36u as=0.52p ps=2.9u w=0.8u l=0.28u
X95 start a_47028_19064# done start nfet_03v3 ad=0.66p pd=3.64u as=0.305p ps=2.22u w=0.5u l=0.28u
X96 start start a_34108_29600# start pfet_03v3 ad=1.38p pd=4.76u as=0.65p ps=3.3u w=1u l=0.28u
X97 start a_45308_1200# a_46508_1200# start nfet_03v3 ad=0.66p pd=3.64u as=0.305p ps=2.22u w=0.5u l=0.28u
X98 start a_45308_6800# a_46508_6800# start nfet_03v3 ad=0.66p pd=3.64u as=0.305p ps=2.22u w=0.5u l=0.28u
X99 start a_12508_37600# dout[2] start pfet_03v3 ad=1.104p pd=4.36u as=0.52p ps=2.9u w=0.8u l=0.28u
X100 start a_18508_6160# a_17308_6160# start pfet_03v3 ad=0.6034p pd=3.64u as=0.2822p ps=2.18u w=0.42u l=2u
X101 start a_34508_6800# a_35708_6800# start pfet_03v3 ad=1.38p pd=4.76u as=0.65p ps=3.3u w=1u l=0.28u
X102 start a_42508_41600# a_43708_41600# start pfet_03v3 ad=1.38p pd=4.76u as=0.65p ps=3.3u w=1u l=0.28u
X103 start a_7708_46000# a_8908_46000# start pfet_03v3 ad=1.38p pd=4.76u as=0.65p ps=3.3u w=1u l=0.28u
X104 start a_50228_9464# a_49028_9464# start nfet_03v3 ad=0.66p pd=3.64u as=0.305p ps=2.22u w=0.5u l=0.28u
X105 start comp_out_p comp_out_p start pfet_03v3 ad=1.38p pd=4.76u as=0.65p ps=3.3u w=1u l=0.28u
X106 start start dac_in[4] start pfet_03v3 ad=1.38p pd=4.76u as=0.65p ps=3.3u w=1u l=0.28u
X107 start a_43828_54264# a_43708_54400# start pfet_03v3 ad=1.104p pd=4.36u as=0.52p ps=2.9u w=0.8u l=0.28u
X108 a_20908_1360# a_17308_1360# a_23308_1360# start nfet_03v3 ad=0.305p pd=2.22u as=0.305p ps=2.22u w=0.5u l=0.28u
X109 start dac_in[2] dac_in[2] start pfet_03v3 ad=1.104p pd=4.36u as=0.52p ps=2.9u w=0.8u l=0.28u
X110 start comp_out_p comp_out_p start pfet_03v3 ad=1.38p pd=4.76u as=0.65p ps=3.3u w=1u l=0.28u
X111 start a_23428_10824# a_22108_10960# start pfet_03v3 ad=1.38p pd=4.76u as=0.65p ps=3.3u w=1u l=0.28u
X112 start dout[2] a_18508_37600# start nfet_03v3 ad=0.577p pd=3.52u as=0.2646p ps=2.1u w=0.42u l=0.28u
X113 start start a_40908_24800# start pfet_03v3 ad=1.104p pd=4.36u as=0.52p ps=2.9u w=0.8u l=0.28u
X114 start a_38908_41600# a_48508_41600# start nfet_03v3 ad=0.577p pd=3.52u as=0.2646p ps=2.1u w=0.42u l=0.28u
X115 start start a_34108_33600# start nfet_03v3 ad=0.66p pd=3.64u as=0.305p ps=2.22u w=0.5u l=0.28u
X116 start a_55028_3864# a_53828_3864# start nfet_03v3 ad=0.66p pd=3.64u as=0.305p ps=2.22u w=0.5u l=0.28u
X117 start a_12508_41600# dout[3] start nfet_03v3 ad=0.577p pd=3.52u as=0.2646p ps=2.1u w=0.42u l=0.28u
X118 start a_3428_1424# start start pfet_03v3 ad=0.65p pd=3.3u as=0 ps=0 w=1u l=0.28u
X119 start a_38108_12400# a_39308_12400# start nfet_03v3 ad=0.66p pd=3.64u as=0.305p ps=2.22u w=0.5u l=0.28u
X120 start a_22108_15760# a_24508_15760# start nfet_03v3 ad=0.66p pd=3.64u as=0.305p ps=2.22u w=0.5u l=0.28u
X121 start comp_out_p comp_out_p start nfet_03v3 ad=0.66p pd=3.64u as=0.305p ps=2.22u w=0.5u l=0.28u
X122 start done a_33308_24800# start nfet_03v3 ad=0.66p pd=3.64u as=0.305p ps=2.22u w=0.5u l=0.28u
X123 start rst_latch rst_latch start nfet_03v3 ad=0.577p pd=3.52u as=0.2646p ps=2.1u w=0.42u l=0.28u
X124 start a_44228_15064# a_44108_15200# start nfet_03v3 ad=0.66p pd=3.64u as=0.305p ps=2.22u w=0.5u l=0.28u
X125 start a_17308_46000# a_18508_46000# start nfet_03v3 ad=0.66p pd=3.64u as=0.305p ps=2.22u w=0.5u l=0.28u
X126 start a_34508_1200# a_35708_1200# start pfet_03v3 ad=1.38p pd=4.76u as=0.65p ps=3.3u w=1u l=0.28u
X127 start a_10628_6024# a_9494_4800# start nfet_03v3 ad=0.66p pd=3.64u as=0.305p ps=2.22u w=0.5u l=0.28u
X128 start a_43708_37600# dout[6] start nfet_03v3 ad=0.577p pd=3.52u as=0.2646p ps=2.1u w=0.42u l=0.28u
X129 start a_36908_54400# dac_in[5] start pfet_03v3 ad=1.38p pd=4.76u as=0.65p ps=3.3u w=1u l=0.28u
X130 start a_40628_3864# a_39428_3864# start nfet_03v3 ad=0.66p pd=3.64u as=0.305p ps=2.22u w=0.5u l=0.28u
X131 start a_15028_6024# a_14908_6160# start nfet_03v3 ad=0.66p pd=3.64u as=0.305p ps=2.22u w=0.5u l=0.28u
X132 start dac_in[3] dac_in[3] start pfet_03v3 ad=1.104p pd=4.36u as=0.52p ps=2.9u w=0.8u l=0.28u
X133 start a_55028_9464# a_53828_9464# start nfet_03v3 ad=0.66p pd=3.64u as=0.305p ps=2.22u w=0.5u l=0.28u
X134 start a_40508_12400# a_41708_12400# start nfet_03v3 ad=0.66p pd=3.64u as=0.305p ps=2.22u w=0.5u l=0.28u
X135 start start a_32694_49200# start nfet_03v3 ad=0.66p pd=3.64u as=0.305p ps=2.22u w=0.5u l=0.28u
X136 start a_44228_9464# a_43028_9464# start pfet_03v3 ad=1.38p pd=4.76u as=0.65p ps=3.3u w=1u l=0.28u
X137 start start a_4294_28400# start nfet_03v3 ad=0.66p pd=3.64u as=0.305p ps=2.22u w=0.5u l=0.28u
X138 start a_22108_15760# a_20908_15760# start pfet_03v3 ad=0.6034p pd=3.64u as=0.2822p ps=2.18u w=0.42u l=2u
X139 start a_2228_10824# a_2108_10960# start pfet_03v3 ad=1.38p pd=4.76u as=0.65p ps=3.3u w=1u l=0.28u
X140 a_3308_6160# a_2108_6160# a_4508_6160# start pfet_03v3 ad=0.65p pd=3.3u as=0.65p ps=3.3u w=1u l=0.28u
X141 start a_30228_54264# start start nfet_03v3 ad=0.2646p pd=2.1u as=0 ps=0 w=0.42u l=0.28u
X142 start comp_out_p comp_out_p start pfet_03v3 ad=1.38p pd=4.76u as=0.65p ps=3.3u w=1u l=0.28u
X143 start a_18508_29600# a_19708_29600# start pfet_03v3 ad=1.38p pd=4.76u as=0.65p ps=3.3u w=1u l=0.28u
X144 a_3308_20560# a_2108_20560# a_4508_20560# start pfet_03v3 ad=0.65p pd=3.3u as=0.65p ps=3.3u w=1u l=0.28u
X145 start a_48508_33600# a_50908_33600# start pfet_03v3 ad=1.38p pd=4.76u as=0.65p ps=3.3u w=1u l=0.28u
X146 start a_54908_12400# a_56108_12400# start pfet_03v3 ad=1.38p pd=4.76u as=0.65p ps=3.3u w=1u l=0.28u
X147 start a_3428_15624# a_3308_15760# start nfet_03v3 ad=0.66p pd=3.64u as=0.305p ps=2.22u w=0.5u l=0.28u
X148 start dac_in[5] dac_in[5] start pfet_03v3 ad=1.104p pd=4.36u as=0.52p ps=2.9u w=0.8u l=0.28u
X149 start a_61028_15064# a_59828_15064# start pfet_03v3 ad=1.38p pd=4.76u as=0.65p ps=3.3u w=1u l=0.28u
X150 start a_40628_9464# a_39428_9464# start nfet_03v3 ad=0.66p pd=3.64u as=0.305p ps=2.22u w=0.5u l=0.28u
X151 start comp_out_p a_4108_41600# start pfet_03v3 ad=1.38p pd=4.76u as=0.65p ps=3.3u w=1u l=0.28u
X152 a_20908_1360# start a_23308_1360# start pfet_03v3 ad=0.65p pd=3.3u as=0.65p ps=3.3u w=1u l=0.28u
X153 a_35494_40400# comp_out_p a_35308_41600# start nfet_03v3 ad=0.305p pd=2.22u as=0.305p ps=2.22u w=0.5u l=0.28u
X154 start a_58508_12400# a_59708_12400# start nfet_03v3 ad=0.66p pd=3.64u as=0.305p ps=2.22u w=0.5u l=0.28u
X155 start a_18508_33600# a_19894_32400# start nfet_03v3 ad=0.66p pd=3.64u as=0.305p ps=2.22u w=0.5u l=0.28u
X156 start a_13708_46000# a_14908_46000# start pfet_03v3 ad=1.38p pd=4.76u as=0.65p ps=3.3u w=1u l=0.28u
X157 start a_45428_3864# a_44228_3864# start nfet_03v3 ad=0.66p pd=3.64u as=0.305p ps=2.22u w=0.5u l=0.28u
X158 start a_37028_54264# a_36908_54400# start nfet_03v3 ad=0.577p pd=3.52u as=0.2646p ps=2.1u w=0.42u l=0.28u
X159 start a_11308_29600# a_12508_29600# start pfet_03v3 ad=1.38p pd=4.76u as=0.65p ps=3.3u w=1u l=0.28u
X160 start a_35308_29600# a_35308_29600# start pfet_03v3 ad=1.38p pd=4.76u as=0.65p ps=3.3u w=1u l=0.28u
X161 start a_44228_3864# a_43028_3864# start pfet_03v3 ad=1.38p pd=4.76u as=0.65p ps=3.3u w=1u l=0.28u
X162 start a_22108_6160# a_20908_6160# start nfet_03v3 ad=0.577p pd=3.52u as=0.2646p ps=2.1u w=0.42u l=2.4u
X163 start a_41308_33600# a_43708_33600# start pfet_03v3 ad=1.38p pd=4.76u as=0.65p ps=3.3u w=1u l=0.28u
X164 a_3308_15760# a_2108_15760# a_4508_15760# start pfet_03v3 ad=0.65p pd=3.3u as=0.65p ps=3.3u w=1u l=0.28u
X165 start start start start nfet_03v3 ad=0.305p pd=2.22u as=0 ps=0 w=0.5u l=0.28u
X166 start a_49028_9464# a_47828_9464# start pfet_03v3 ad=1.38p pd=4.76u as=0.65p ps=3.3u w=1u l=0.28u
X167 start start a_2908_37600# start pfet_03v3 ad=1.38p pd=4.76u as=0.65p ps=3.3u w=1u l=0.28u
X168 start a_2908_33600# a_10108_33600# start pfet_03v3 ad=1.104p pd=4.36u as=0.52p ps=2.9u w=0.8u l=0.28u
X169 start a_36908_1200# a_38108_1200# start nfet_03v3 ad=0.66p pd=3.64u as=0.305p ps=2.22u w=0.5u l=0.28u
X170 start a_20908_6160# a_22108_6160# start pfet_03v3 ad=1.38p pd=4.76u as=0.65p ps=3.3u w=1u l=0.28u
X171 start a_8108_6160# a_9308_6160# start pfet_03v3 ad=1.38p pd=4.76u as=0.65p ps=3.3u w=1u l=0.28u
X172 start a_49708_29600# a_51094_28400# start nfet_03v3 ad=0.66p pd=3.64u as=0.305p ps=2.22u w=0.5u l=0.28u
X173 start dac_in[6] dac_in[6] start pfet_03v3 ad=1.104p pd=4.36u as=0.52p ps=2.9u w=0.8u l=0.28u
X174 start a_4508_20560# a_5708_20560# start nfet_03v3 ad=0.66p pd=3.64u as=0.305p ps=2.22u w=0.5u l=0.28u
X175 start a_53828_15064# a_52628_15064# start pfet_03v3 ad=1.38p pd=4.76u as=0.65p ps=3.3u w=1u l=0.28u
X176 start a_50508_50400# a_50628_54264# start pfet_03v3 ad=1.38p pd=4.76u as=0.65p ps=3.3u w=1u l=0.28u
X177 start a_22108_10960# a_24508_10960# start nfet_03v3 ad=0.66p pd=3.64u as=0.305p ps=2.22u w=0.5u l=0.28u
X178 start a_11308_33600# a_12694_32400# start nfet_03v3 ad=0.66p pd=3.64u as=0.305p ps=2.22u w=0.5u l=0.28u
X179 start comp_out_p comp_out_p start nfet_03v3 ad=0.66p pd=3.64u as=0.305p ps=2.22u w=0.5u l=0.28u
X180 start a_50628_54264# a_50508_54400# start nfet_03v3 ad=0.577p pd=3.52u as=0.2646p ps=2.1u w=0.42u l=0.28u
X181 start a_34108_29600# a_41308_29600# start pfet_03v3 ad=1.104p pd=4.36u as=0.52p ps=2.9u w=0.8u l=0.28u
X182 a_43094_18000# start a_42908_19200# start nfet_03v3 ad=0.305p pd=2.22u as=0.305p ps=2.22u w=0.5u l=0.28u
X183 start a_56108_1200# a_57308_1200# start nfet_03v3 ad=0.66p pd=3.64u as=0.305p ps=2.22u w=0.5u l=0.28u
X184 start a_45428_9464# a_44228_9464# start nfet_03v3 ad=0.66p pd=3.64u as=0.305p ps=2.22u w=0.5u l=0.28u
X185 start a_19708_37600# dout[2] start pfet_03v3 ad=1.104p pd=4.36u as=0.52p ps=2.9u w=0.8u l=0.28u
X186 start a_24508_1360# a_23308_1360# start pfet_03v3 ad=0.6034p pd=3.64u as=0.2822p ps=2.18u w=0.42u l=2u
X187 start a_34628_9464# a_33428_9464# start pfet_03v3 ad=1.38p pd=4.76u as=0.65p ps=3.3u w=1u l=0.28u
X188 start a_49708_41600# a_50908_41600# start pfet_03v3 ad=1.38p pd=4.76u as=0.65p ps=3.3u w=1u l=0.28u
X189 start start a_2908_41600# start nfet_03v3 ad=0.66p pd=3.64u as=0.305p ps=2.22u w=0.5u l=0.28u
X190 start start a_4108_50400# start pfet_03v3 ad=1.104p pd=4.36u as=0.52p ps=2.9u w=0.8u l=0.28u
X191 start a_41708_12400# a_42908_12400# start pfet_03v3 ad=1.38p pd=4.76u as=0.65p ps=3.3u w=1u l=0.28u
X192 start a_49028_15064# a_47828_15064# start nfet_03v3 ad=0.66p pd=3.64u as=0.305p ps=2.22u w=0.5u l=0.28u
X193 start a_49028_3864# sample_en start pfet_03v3 ad=1.38p pd=4.76u as=0.65p ps=3.3u w=1u l=0.28u
X194 start a_5308_46000# a_6508_46000# start nfet_03v3 ad=0.66p pd=3.64u as=0.305p ps=2.22u w=0.5u l=0.28u
X195 start dout[0] a_11308_29600# start nfet_03v3 ad=0.577p pd=3.52u as=0.2646p ps=2.1u w=0.42u l=0.28u
X196 start a_46508_1200# a_47708_1200# start nfet_03v3 ad=0.66p pd=3.64u as=0.305p ps=2.22u w=0.5u l=0.28u
X197 start a_59828_9464# a_58628_9464# start pfet_03v3 ad=1.38p pd=4.76u as=0.65p ps=3.3u w=1u l=0.28u
X198 start a_34108_33600# a_41308_33600# start nfet_03v3 ad=0.577p pd=3.52u as=0.2646p ps=2.1u w=0.42u l=0.28u
X199 start a_10628_20424# a_9308_20560# start pfet_03v3 ad=1.38p pd=4.76u as=0.65p ps=3.3u w=1u l=0.28u
X200 start a_41708_6800# a_42908_6800# start pfet_03v3 ad=1.38p pd=4.76u as=0.65p ps=3.3u w=1u l=0.28u
X201 start a_19708_41600# dout[3] start nfet_03v3 ad=0.577p pd=3.52u as=0.2646p ps=2.1u w=0.42u l=0.28u
X202 start a_45308_12400# a_46508_12400# start nfet_03v3 ad=0.66p pd=3.64u as=0.305p ps=2.22u w=0.5u l=0.28u
X203 start a_9708_50400# a_9828_54264# start pfet_03v3 ad=1.38p pd=4.76u as=0.65p ps=3.3u w=1u l=0.28u
X204 start dout[3] a_23308_50400# start pfet_03v3 ad=1.104p pd=4.36u as=0.52p ps=2.9u w=0.8u l=0.28u
X205 a_24694_0# a_23308_1360# a_24508_1360# start nfet_03v3 ad=0.305p pd=2.22u as=0.305p ps=2.22u w=0.5u l=0.28u
X206 start start a_33308_24800# start nfet_03v3 ad=0.66p pd=3.64u as=0.305p ps=2.22u w=0.5u l=0.28u
X207 start a_5708_10960# a_4508_10960# start pfet_03v3 ad=0.6034p pd=3.64u as=0.2822p ps=2.18u w=0.42u l=2u
X208 start dac_in[4] dac_in[4] start nfet_03v3 ad=0.577p pd=3.52u as=0.2646p ps=2.1u w=0.42u l=0.28u
X209 a_46294_53200# a_43708_54400# dac_in[6] start nfet_03v3 ad=0.305p pd=2.22u as=0.305p ps=2.22u w=0.5u l=0.28u
X210 start a_8108_20560# a_9308_20560# start pfet_03v3 ad=1.38p pd=4.76u as=0.65p ps=3.3u w=1u l=0.28u
X211 start a_51428_15064# a_50228_15064# start nfet_03v3 ad=0.66p pd=3.64u as=0.305p ps=2.22u w=0.5u l=0.28u
X212 start a_35828_3864# a_34628_3864# start nfet_03v3 ad=0.66p pd=3.64u as=0.305p ps=2.22u w=0.5u l=0.28u
X213 start dout[3] a_11308_41600# start pfet_03v3 ad=1.104p pd=4.36u as=0.52p ps=2.9u w=0.8u l=0.28u
X214 a_5708_15760# a_2108_15760# a_8108_15760# start nfet_03v3 ad=0.305p pd=2.22u as=0.305p ps=2.22u w=0.5u l=0.28u
X215 start a_34628_3864# a_33428_3864# start pfet_03v3 ad=1.38p pd=4.76u as=0.65p ps=3.3u w=1u l=0.28u
X216 start a_34508_12400# a_35708_12400# start pfet_03v3 ad=1.38p pd=4.76u as=0.65p ps=3.3u w=1u l=0.28u
X217 start a_50908_37600# dout[6] start nfet_03v3 ad=0.577p pd=3.52u as=0.2646p ps=2.1u w=0.42u l=0.28u
X218 start a_39428_9464# a_38228_9464# start pfet_03v3 ad=1.38p pd=4.76u as=0.65p ps=3.3u w=1u l=0.28u
X219 start a_15028_10824# a_14908_10960# start pfet_03v3 ad=1.38p pd=4.76u as=0.65p ps=3.3u w=1u l=0.28u
X220 start dout[6] a_42508_37600# start pfet_03v3 ad=1.104p pd=4.36u as=0.52p ps=2.9u w=0.8u l=0.28u
X221 start a_10628_15624# a_9308_15760# start pfet_03v3 ad=1.38p pd=4.76u as=0.65p ps=3.3u w=1u l=0.28u
X222 start a_59828_3864# a_58628_3864# start pfet_03v3 ad=1.38p pd=4.76u as=0.65p ps=3.3u w=1u l=0.28u
X223 start a_16508_50400# a_16628_54264# start pfet_03v3 ad=1.38p pd=4.76u as=0.65p ps=3.3u w=1u l=0.28u
X224 start a_41708_1200# a_42908_1200# start pfet_03v3 ad=1.38p pd=4.76u as=0.65p ps=3.3u w=1u l=0.28u
X225 start a_16228_15624# a_16108_15760# start nfet_03v3 ad=0.66p pd=3.64u as=0.305p ps=2.22u w=0.5u l=0.28u
X226 start a_16628_54264# a_16508_54400# start nfet_03v3 ad=0.577p pd=3.52u as=0.2646p ps=2.1u w=0.42u l=0.28u
X227 start dout[0] a_18508_29600# start pfet_03v3 ad=1.104p pd=4.36u as=0.52p ps=2.9u w=0.8u l=0.28u
X228 start a_35828_9464# a_34628_9464# start nfet_03v3 ad=0.66p pd=3.64u as=0.305p ps=2.22u w=0.5u l=0.28u
X229 start comp_done a_2908_46000# start pfet_03v3 ad=1.38p pd=4.76u as=0.65p ps=3.3u w=1u l=0.28u
X230 start comp_out_p a_48508_33600# start pfet_03v3 ad=1.104p pd=4.36u as=0.52p ps=2.9u w=0.8u l=0.28u
X231 start a_8108_15760# a_9308_15760# start pfet_03v3 ad=1.38p pd=4.76u as=0.65p ps=3.3u w=1u l=0.28u
X232 start a_2228_1424# start start pfet_03v3 ad=0.52p pd=2.9u as=0 ps=0 w=0.8u l=0.28u
X233 start a_18628_1224# a_18508_1360# start pfet_03v3 ad=1.38p pd=4.76u as=0.65p ps=3.3u w=1u l=0.28u
X234 start a_52508_6800# a_53708_6800# start pfet_03v3 ad=1.38p pd=4.76u as=0.65p ps=3.3u w=1u l=0.28u
X235 start a_9308_20560# a_11708_20560# start nfet_03v3 ad=0.66p pd=3.64u as=0.305p ps=2.22u w=0.5u l=0.28u
X236 start a_12508_33600# dout[1] start pfet_03v3 ad=1.104p pd=4.36u as=0.52p ps=2.9u w=0.8u l=0.28u
X237 a_12694_36400# a_10108_37600# a_12508_37600# start nfet_03v3 ad=0.305p pd=2.22u as=0.305p ps=2.22u w=0.5u l=0.28u
X238 start dout[7] a_42508_41600# start nfet_03v3 ad=0.577p pd=3.52u as=0.2646p ps=2.1u w=0.42u l=0.28u
X239 start a_58628_15064# a_57428_15064# start pfet_03v3 ad=1.38p pd=4.76u as=0.65p ps=3.3u w=1u l=0.28u
X240 start a_39428_3864# a_38228_3864# start pfet_03v3 ad=1.38p pd=4.76u as=0.65p ps=3.3u w=1u l=0.28u
X241 start start a_30228_54264# start pfet_03v3 ad=1.38p pd=4.76u as=0.65p ps=3.3u w=1u l=0.28u
X242 start dout[6] a_43708_50400# start pfet_03v3 ad=1.104p pd=4.36u as=0.52p ps=2.9u w=0.8u l=0.28u
X243 start a_33428_12264# a_33308_12400# start nfet_03v3 ad=0.66p pd=3.64u as=0.305p ps=2.22u w=0.5u l=0.28u
X244 start a_3028_54264# a_2908_54400# start pfet_03v3 ad=1.104p pd=4.36u as=0.52p ps=2.9u w=0.8u l=0.28u
X245 start a_16628_54264# a_16628_54264# start pfet_03v3 ad=1.104p pd=4.36u as=0.52p ps=2.9u w=0.8u l=0.28u
X246 start a_42908_6800# a_44108_6800# start nfet_03v3 ad=0.66p pd=3.64u as=0.305p ps=2.22u w=0.5u l=0.28u
X247 start dac_in[7] dac_in[7] start nfet_03v3 ad=0.577p pd=3.52u as=0.2646p ps=2.1u w=0.42u l=0.28u
X248 start dout[1] a_18508_33600# start nfet_03v3 ad=0.577p pd=3.52u as=0.2646p ps=2.1u w=0.42u l=0.28u
X249 a_16108_6160# a_14908_6160# a_17308_6160# start pfet_03v3 ad=0.65p pd=3.3u as=0.65p ps=3.3u w=1u l=0.28u
X250 start a_33428_6664# a_33308_6800# start pfet_03v3 ad=1.38p pd=4.76u as=0.65p ps=3.3u w=1u l=0.28u
X251 start a_43708_29600# dout[4] start pfet_03v3 ad=1.104p pd=4.36u as=0.52p ps=2.9u w=0.8u l=0.28u
X252 a_16108_15760# a_14908_15760# a_17308_15760# start pfet_03v3 ad=0.65p pd=3.3u as=0.65p ps=3.3u w=1u l=0.28u
X253 start a_11308_46000# a_12508_46000# start nfet_03v3 ad=0.66p pd=3.64u as=0.305p ps=2.22u w=0.5u l=0.28u
X254 start a_47708_1200# a_48908_1200# start nfet_03v3 ad=0.66p pd=3.64u as=0.305p ps=2.22u w=0.5u l=0.28u
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
