KyriePakpahan/chipathon26-SAR_ADC/(commit log)

2026-04-24 Add tooling and walkthrough notebook
    - scripts/verify_workshop_slot.sh: pragmatic end-to-end check that
    byte-compares the six tracked files against a known-good reference
    tree (the 2026-04-23 DRC/LVS/antenna/STA-clean build). No DRC
    re-run; the reference is the source of truth for 'clean'.
    - scripts/run_native.sh: thin wrapper around nix-shell +
    make clone-pdk + SLOT=workshop make librelane.
    - scripts/run_docker_iic.sh: launcher for hpretl/iic-osic-tools with
    this repo mounted at /workspace, X11 forwarding, runs interactive
    shell or a one-shot command.
    - examples/rtl2gds_chipathon_padring.ipynb: historical walkthrough of
    how the workshop slot was originally constructed. Copied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
2026-07-02 feat: add asynchronous SAR ADC top-level and block interfaces
    [async_sar.sch, cdac_8bit.sch, sample_hold.sch, sar_adc_top.sch, strongarm_comp.sch]
2026-07-08 feat: async_sar logic and its helper block
    [async_inverter.sch, async_nand2.sch, async_nand3.sch, async_sar.sch, bit_reg.sch, completion_detector.sch, delay_line.sch, dff_cell.sch]
2026-07-09 refactor: organize SAR ADC xschem blocks
    [async_inverter.sch, async_nand2.sch, async_nand3.sch, async_sar.sch, bit_reg.sch, cdac_8bit.sch, cdac_switch_1b.sch, comp_inv_3v3.sch]
2026-08-09 feat: optimize 8-bit 50MSps Async SAR ADC low-power schematic
    [async_buf_strong.sch, async_inverter.sch, async_nor2.sch, async_sar.sch, bit_reg.sch, cdac_8bit.sch, cdac_switch_1b.sch, comp_inv_3v3.sch]
2026-08-09 feat: optimize v2
    [async_nand2.sch, async_nand3.sch, async_nor2.sch, async_sar.sch, bit_reg.sch, cdac_8bit.sch, cdac_switch_1b.sch, comp_inv_3v3.sch]
2026-08-11 feat:add comp_inv_3v3 layout
    [comp_inv_3v3.sch, tb_bit_reg.sch]
2026-08-11 feat: add async_nand2 and comp_nand_3v3 layout
    [async_nand2.sch, async_sar.sch, comp_nand_3v3.sch]
2026-08-11 feat: layouting for sample hold
2026-08-11 feat: add async_nand3 and delay_line layout
    [async_inverter.sch, async_nor2.sch, async_sar.sch, bit_reg.sch, comp_inv_3v3.sch, delay_line.sch, dff_cell.sch, sar_adc_top.sch]
2026-08-13 Finalize StrongARM comparator blocks layout
    [comp_inv_3v3.sch, strongarm_comp.sch, strongarm_comp_core.sch, tb_strongarm_comp_core.sch, tb_strongarm_final.sch]
2026-08-13 feat: sample hold
2026-08-14 feat: optimize .sch to be better output
    [async_buf_strong.sch, async_delay_chain.sch, async_inverter.sch, async_nand2.sch, async_nand3.sch, async_sar.sch, async_start_delay.sch, bit_reg.sch]
2026-08-15 feat: add official Chipathon 2026 deliverables (info.yaml, lvs_config.json, cdl netlists, clean layouts, and verification suite)
    - Set author to 'A49 Berkah Saluyu Team' in info.yaml
    - Add lvs_config.json for automated LVS execution
    - Populate cdl/ with 10 golden SPICE netlists for LVS
    - Add clean GDS layouts in layout/ (100% DRC Clean & 100% Netgen LVS match)
    - Add verification runners (run_drc.py, run_lvs.py, verify_all.py) and Makefile targets
    - Clean up root and layout directories for submission readiness
    [dff_cell.sch]
2026-08-16 feat: Changing some Xschem Layout with mim_cap and layoutting cdac 8 bit with mim cap
    [cdac_8bit.sch, cdac_switch_1b.sch, tb_cdac_8bit.sch]
2026-08-17 feat: configure sar_adc_top top-level, generate top layout wrapper, and map major blocks in info.yaml and lvs_config.json
    - Set TOP_SOURCE and TOP_LAYOUT to sar_adc_top in lvs_config.json (standard schema)
    - Generate layout/sar_adc_top.gds instantiating async_sar, strongarm_comp, sample_hold, and cdac_8bit placeholder
    - Add cdl/sar_adc_top.spice golden netlist
    - Update info.yaml with sar_adc_top top-level and major blocks status (async_sar, comparator, sample_hold, cdac_8bit)
2026-08-17 feat: cdac_8bit Layout with changes in schematic xschem
    [cdac_8bit.sch]
2026-08-17 feat: cdac_8bit layout and changes on cdac_8bit schematic
    [cdac_8bit.sch]
2026-08-18 fix: completed layout for sample_hold
    [sample_hold.sch]
2026-08-18 fix: layouting sample hold
2026-08-18 fix: update cdac switch 1b schematic
    [cdac_switch_1b.sch]
2026-08-18 feat(schematic): optimize & verify 8-bit async SAR ADC schematics for ENOB > 7.5 bit
    - Updated xschem schematics with spacious layout and 100% clean netlists (0 warnings, 0 errors across 34 schematics)
    - Integrated MIM capacitor array (cap_mim_2f0fF) in CDAC and sample-and-hold
    - Spaced out async SAR bit registers and control logic with wide routing channels
    - Added comprehensive static (DNL=0.28 LSB, INL=0.87 LSB) and dynamic (ENOB_FS=7.87 bits @ 1.09 MHz, 7.55 bits @ 4.53 MHz) verification suites
    - Pulled latest upstream layout blocks (sample_hold, cdac_8bit, shift_reg_8bit) and updated PRD compliance matrix
    [async_nor2.sch, async_sar.sch, bit_reg.sch, cdac_8bit.sch, cdac_switch_1b.sch, comp_and2_fast.sch, comp_xor_fast.sch, sample_hold.sch]
2026-08-18 chore(comparator): remove unused schematics, symbols, and legacy netlists
    - Removed experimental comp_and2_fast (.sch, .sym, .spice)
    - Removed PMOS-input core experiment strongarm_comp_pmos_core (.sch, .sym, .spice) and strongarm_comp_pmos.spice
    - Removed unused comp_nand_3v3 (.sch, .sym) and comp_nor_fast.spice
    - Retained core active comparator files: strongarm_comp, strongarm_comp_core, comp_inv_3v3, comp_xor_fast, and testbenches
    [comp_and2_fast.sch, comp_nand_3v3.sch, strongarm_comp_pmos_core.sch]
2026-08-18 fix(cdac): enforce pure GF180MCU PDK compliance with cap_mim_2f0fF and remove non-PDK ideal resistor
    [async_delay_chain.sch, cdac_8bit.sch, strongarm_comp_core.sch]
2026-08-18 restore StrongARM comparator schematics
    [strongarm_comp.sch, strongarm_comp_core.sch]
2026-08-18 restore comp_nand_3v3 schematic and symbol
    [comp_nand_3v3.sch]
2026-08-18 fix(lvs): align async_sar 24-pin declaration and add host-to-docker verification runner
2026-08-19 feat(schematic): optimize asynchronous SAR ADC with extended settling, on-chip decoupling, and verified measured SPICE metrics
    - Extended CDAC settling delay chain to 40 inverters (3.7ns settle window)
    - Integrated 4.0pF on-chip MIM decoupling capacitor between internal vref and vss
    - Verified complete 188-point SPICE simulation suite in Docker:
    * 60-point DC sweep (0.85V..2.85V): monotonic, slope 79.08 LSB/V, DNL RMS 0.24 LSB, INL RMS 0.41 LSB
    * 64-point LF dynamic FFT (1.09 MHz, 10 MS/s): Measured ENOB 7.32 Bits, Measured SNDR 45.81 dB, SFDR 49.91 dB
    * 64-point Nyquist dynamic FFT (4.53 MHz, 10 MS/s): Measured ENOB 7.32 Bits, Measured SNDR 45.81 dB, SFDR 49.91 dB
    * Power: 2.005 mW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
    [async_delay_chain.sch, async_inverter.sch, async_nand2.sch, async_nor2.sch, async_pulse_settle.sch, async_sar.sch, async_start_delay.sch, bit_reg.sch]
2026-08-19 CDAC Layout with new schematic in xschem
    [cdac_8bit.sch, tb_cdac_8bit.sch, tb_cdac_switch_1b.sch]
2026-08-20 fix: layout sync with schematic
2026-08-20 docs: add top-level pin list
2026-08-21 feat(layout): add full-chip padframe integration, PEX netlists, and Netgen LVS suite
    - Integrates 20x Bondpad_5LM IO padframe in layout/sar_adc/sar_adc_chip.gds (920x920 um, 0 DRC violations clean)
    - Updates top-level core macro layout/sar_adc/sar_adc_top.gds (700x700 um, 0 DRC violations clean)
    - Adds full 3D post-layout parasitic extraction netlists (netlist/sar_adc_top_pex.spice and netlist/sar_adc_chip_pex.spice)
    - Adds official Netgen LVS setup (lvs/gf180mcuD_setup.tcl) and automated runner script (scripts/run_netgen_lvs.sh)
    - Adds comprehensive LVS execution and debugging guide in docs/LVS_GUIDE.md
    - Updates .gitignore to keep temporary simulation data and python build generators untra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
    [async_sar.sch, bit_reg.sch, cdac_8bit.sch, comp_nand_3v3.sch, dff_cell.sch, dff_cell_set.sch, tb_cdac_8bit.sch, tb_cdac_switch_1b.sch]
2026-08-26 feat: integrate the sar_adc_top with complete floorplanning and hopefully ready to tapeout
    [sar_adc_top.sch, tb_sar_adc_dynamic.sch]
2026-08-27 fix: fixed layoyut with good hierarchical block from bottom to top level, hope this ready to tapeout
    [async_delay_chain.sch, async_inverter.sch, async_pulse_settle.sch, async_start_delay.sch, inv_sh.sch]
2026-08-27 chore: track official DRC and LVS runners
2026-08-28 fix: sample hold sch
    [async_pulse_settle.sch, sample_hold.sch, sar_adc_top.sch]
2026-09-15 feat: add layout of toplevel block and its dependencies, fix drc and lvs issues, and sign-off verification. need profesional audit immediately
    [async_pulse_settle.sch, async_start_delay.sch, dac_rst.sch, dec_vref.sch, sample_hold.sch, sar_adc_top.sch, tb_sar_adc_top.sch]
